ZeroPhone/ZeroPhone-PCBs/README.md

# ZeroPhone-PCBs
KiCad PCB files for ZeroPhone - Delta revision

## For Gerber and schematic files, [go to the "Releases" tab!](https://github.com/ZeroPhone/ZeroPhone-PCBs/releases/tag/delta-b)
