ZeroPhone/ZeroPhone-PCBs/art/220px-Glider.bmp

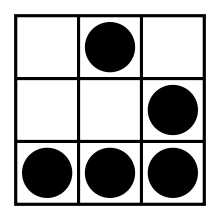
art/220px-Glider.bmp
