ZeroPhone/ZeroPhone-PCBs/bom_and_description.xls

Description | Board reference | Name, type | QTY | Price/QTY1 (per pcs) | Price/QTY1000 (per pcs) | Supplier | Notes | $/pcs when making 1000 phones | $/phone when making 1000 phones
 |  |  |  |  |  |  | QTY1 prices taken from local sellers (Riga, Latvia)/eBay
 |  |  |  |  |  |  | GBP to USD: | $1.2460
Transistors (keypad backlight&vibromotor control) | Front: Q1,Q2 | BC847B, SOT-23 | 2 | £0.07 | £0.04170 | Farnell |  | $0.0520 | 0.10
Bypass capacitors | Front: C1,C4,C5,C6,C7,C8,C13,C14,C25; Back: C5,C6,C7,C8,C13,C14,C25,C15 | 100nF, 0805 | 17 | £0.05 | £0.00440 | Farnell |  | $0.0055 | 0.09
ATMega crystal capacitors (for HC49) | Front: C2,C3 | 18pF, 0805 | 2 | £0.05 | £0.00320 | Farnell |  | $0.0040 | 0.01
Vibromotor back-EMF protection diode | Front: D1 | 1N4148, SMD (MiniMELF) | 1 | £0.10 | £0.01000 | Farnell |  | $0.0125 | 0.01
ATMega328P, in TQFP | Front: IC1 | ATMEGA328P-AU | 1 | £2 | £1.62000 | Farnell | Should be programmed with Arduino bootloader over SPI first | $2.0185 | 2.02
Resistors | Front: R3,R4,R11,R12,R13; Back: R1,R2,R3,R10,R8,R9,R11 | 10K, 0805 | 12 | £0.05 | £0.00090 | Farnell | Assuming 5000pcs/reel | $0.0011 | 0.01
Resistors (for SDIO connection) | Front: R5,R6,R7,R8,R9,R10 | 47R, 0805 | 6 | £0.05 | £0.00180 | Farnell | 6000 but typical reel is 5000, so have to buy 2 reels | $0.0022 | 0.01
Audio filtering capacitors | Front: C9,C10 | 10uF, 0805 | 2 | £0.05 | £0.02200 | Farnell |  | $0.0274 | 0.05
Audio filtering capacitors | Front: C11,C12 | 33nF, 0603 | 2 | £0.05 | £0.00700 | Farnell | price is 0.0034 but min qty is 4000 | $0.0087 | 0.02
Audio jack | Front: JACK1 | FC68125 | 1 | £0.79 | £0.51000 | Farnell | Same connector that Raspberry Pi B+/A+/2/3 use | $0.6355 | 0.64
Resistor (PWM voltage divider, audio) | Front: R1,R2 | 150R, 0603 | 2 | £0.05 | £0.00015 | Farnell |  | $0.0002 | 0.0003738
Resistor (PWM voltage divider, audio) | Front: R14,R15 | 270R, 0603 | 2 | £0.05 | £0.00015 | Farnell |  | $0.0002 | 0.0003738
ATMega crystal | Front: X1 | 16MHz, HC49 or CSTCE | 1 | £0.5 | £0.13100 | Farnell |  | $0.1632 | 0.16
Audio filtering capacitors | Front: C16,C17,C18,C19,C20,C21; Back: C22,C23,C24 | 33pF, 0603 | 9 | £0.05 | £0.01200 | Farnell | 6000 but typical reel is 5000, so have to buy 2 reels | $0.0150 | 0.13
Audio filtering capacitors | Front: C22,C23,C24; Back: C20,C21,C16,C17,C18,C19 | 10pF, 0603 | 9 | £0.05 | £0.00800 | Farnell | price/pcs is 0.006, need 3000, buying a reel of 5000 | $0.0100 | 0.09
3.3V line bypass capacitor, VBAT line bypass capacitor (for modem) | Front: C15, Back: C4 | 10uF, Tantalum, Case-B | 2 | £0.30 | £0.06000 | Farnell |  | $0.0748 | 0.15
Vibromotor current limiting resistor | Front: R16 | 1R, 0805 | 1 | £0.05 | £0.00500 | Farnell | price is 0.001 but min reel is 5000 | $0.0062 | 0.01
USB female socket | Back: P4 | USB_A | 1 | £0.5 | £0.20000 | Farnell |  | $0.2492 | 0.25
I2C GPIO expander to add GPIOs to the Pi | Back: U3 | MCP23017-E/SO | 1 | £1 | £0.73000 | Farnell |  | $0.9096 | 0.91
Battery connector | Back: P8 | SMD JST connector | 1 | £0.5 | £0.24000 | Farnell |  | $0.2990 | 0.30
RGB LED resistors | Back: R5,R6,R7 | 1K, 0805 | 3 | £0.05 | £0.00120 | Farnell | Real price is 0.0008/pcs, recalculated for 5000 reel | $0.0015 | 0.0044856
P-FETs to switch power lines | Back: Q1,Q4 | IRLML6401, SOT-23 | 2 | £0.3 | £0.07000 | Farnell |  | $0.0872 | 0.17
Schottky diode for power path switching while battery is charging | Back: D1 | SS14, any case | 1 | £0.3 | £0.16100 | Farnell |  | $0.2006 | 0.20
RTC IC | Back: U5 | DS1307, DS1337 or MCP7940N | 1 | £2 | £0.87000 | Farnell |  | $1.0840 | 1.08
RTC crystal | Back: Y1 | 32.768Hz crystal | 1 | £0.5 | £0.25000 | Farnell |  | $0.3115 | 0.31
Notification/flashlight diode | Back: D3 | RGB 5050 LED (either common-anode or common-cathode) | 1 | £1 | £0.76000 | Farnell |  | $0.9470 | 0.95
4-pin switches on the front of keypad board | Keypad: DOWN1,LEFT1,N#1,N*1,N0,N1,N2,N3,N4,N5,N6,N7,N8,N9,OK1,RIGHT1,UP1 | SKQG-like switch, preferably with elongated cap (4x4x3mm) | 17 | 0.06$ | 0.02$ | Aliexpress | keyword: "smd switch 4x4x3", Panasonic name is SKQG, but it has higher buttons | $0.02 | 0.34
2-pin switches on the front of keypad board | Keypad: C1,C2,C3,C4,C5,C6,GREEN1,RED1 | ? | 8 | 0.03$ | ? |  | couldn't yet find the name of the switch, but it's very popular and easy to source, as well as cheap (3.5x6mm) |  | 0
4-pin switches on the back of keypad board | Keypad: OPTION1,PHOTO1,PHOTO2,VOL_DOWN1,VOL_UP1 | SW_SPST_EVQP7C | 5 | 0.12$ | £0.36 | Farnell | EVQP7C switches | $0.4523 | 2.26149
ESP8266 module (for WiFi over SDIO) | Front: U2 | ESP-12E / ESP-12F | 1 | 2$ | ? | eBay |  |  | 0
OLED display | None | 1.3" SPI monochrome OLED (SH1106 controller) | 1 | 6$ | 3-4$ | eBay |  |  | 0
Speaker | None | Unknown (I'm still searching for good ones) | 1 | ? | ? |  |  |  | 0
Microphone | None | Unknown (I'm still searching for good ones) | 1 | ? | ? |  |  |  | 0
40x1 2.54 male header | None | Regular 0.1in header | 1 | £0.10 | ? |  |  |  | 0
20x2 2.54 male header | None | Regular 0.1in header | 1 | £0.10 | ? |  |  |  | 0
Front PCB | None | 4x10cm PCB, 2 layers | 1 | 1.25$ | ? | DirtyPCBs | Panelised with the keypad board (total price divided by count of boards you receive) |  | 0
Keypad PCB | None | 4x6cm PCB, 2 layers | 1 | 1.25$ | ? | DirtyPCBs | Panelised with the front board (total price divided by count of boards you receive) |  | 0
Back PCB | None | 4x10cm PCB, 2 layers | 1 | 2.5$ | ? | DirtyPCBs | (total price divided by count of boards you receive) |  | 0
Raspberry Pi Zero | None |  | 1 | 5$ | ? | Pimoroni | Shipping not included |  | 0
GSM modem | Back: U2 | SIM800L breakout | 1 | 5$ | ? | eBay |  |  | 0
Li-Ion charger board footprint | Back: U4 | TP4056 breakout with protection | 1 | 1$ | ? | eBay |  |  | 0
DC-DC breakout footprint | Back: U6 | G2116-based Chinese DC-DC | 1 | 1$ | ? | eBay |  |  | 0
 |  |  |  |  |  |  |  |  | 10.30
