ZeroPhone/ZeroPhone-PCBs/keypad_pcb/keypad_pcb.csv

Id | Designator | Package | Quantity | Designation | Supplier and ref
1 | DOWN1,LEFT1,N#1,N*1,N0,N1,N2,N3,N4,N5,N6,N7,N8,N9,OK1,RIGHT1,UP1 | SW_SPST_SKQG | 17 | AB2_SWITCH_MOMENTARY
2 |  | keypad_overlay | 1 | KEYPAD_OVERLAY
3 | C1,C2,C3,C4,C5,C6,GREEN1,RED1 | SW_SPST_EVQPE1 | 8 | AB2_SWITCH_MOMENTARY
4 | OPTION1,PHOTO1,PHOTO2,VOL_DOWN1,VOL_UP1 | SW_SPST_EVQP7C | 5 | AB2_SWITCH_MOMENTARY
