ZeroPhone/ZeroPhone-PCBs/TODO.md

#PCB TODO

* Change via drill/annular ring size near pads to make rework less problematic ( #5 )
* UART buffer addition ( #6 )
* Comparators for voltage level measurement (DC-DC overcurrent, incapable charger, main battery shutdown) ( #7 )
* Replace RGB LED by WS2812 ( #8 )
* Add diodes on keypad board ( #9 )
* Switch on USB power - power USB from charger 5V input when on charger ( #10 )
* Add more clarifications to the board schematics
* Add silkscreen + marks for polarized capacitors ( #11 )

Cat picture to make it less boring
