ZeroPhone/ZeroPhone-PCBs/(threads)

Thread 3 (2017-03-01):

EOMA specifications

dumblob, 2017-03-01:
I came across the FAQ on https://hackaday.io/project/19035-zerophone-a-raspberry-pi-smartphone/log/51834-explaining-choices-behind-the-project and wanted to mention, that there is a huge, more than 6 years running effort to:

1. Create EOMA open-source specifications of **interfaces** for HW (not the HW itself), which build upon open-source and libre concepts, eco-consciousness, sustainability over many years, and affordability.
1. Run a world-wide certification authority certifying compliance of devices with EOMA specifications.
1. Boost spreading of EOMA specifications by manufacturing some HW made according to these interfaces specifications (see e.g. https://www.crowdsupply.com/eoma68/micro-desktop ).

For more information visit http://elinux.org/Embedded_Open_Modular_Architecture and http://rhombus-tech.net/ (it's messy, but it's getting better; so far use Ctrl+F on http://rhombus-tech.net/sitemap/ ). Except for desktop PC, notebook and tablet, there is also a [phone](http://rhombus-tech.net/community_ideas/hybrid_phone/ ). These links account for about 40% of information. The whole rest is scattered in the [mailing list archives]http://lists.phcomp.co.uk/mailman/listinfo/arm-netbook ).

Some type of cooperation for the future ZeroPhone2 might be advantageous.

CRImier, 2017-03-04:
Hi! I've been following EOMA project (also, the EOMA68 implementation on CrowdSupply in particular) for some time. I like this concept, hope to get a EOMA68 laptop eventually and I'm considering this standard as one of those I could potentially use. ZeroPhone 2 isn't coming this year, but I'm already collecting information, so thank you for this =)

dumblob, 2017-03-04:
Wow, great news! I'm looking forward to cooperation and hope to hear from you sometimes at the EOMA mailing list.

(feel free to close this issue once there are more issues and things would get messy in the tracker; I'm leaving it open for other people to get a glimpse about a possible future)

CRImier, 2017-03-04:
I hope I'll join and participate in EOMA mailing list, eventually =) EOMA initiative is something that really needs to be worked on, and I'd be more than happy to be a part of it.

Hopefully,  people will continue throwing ideas and links at me - Google doesn't always help =D

Thread 10 (2017-05-14):

Powering the host USB port from charger voltage while ZeroPhone is charging

CRImier, 2017-05-14:
The USB step-up board is one of the only things that's powered from the battery even when the phone is charging (other things are GSM modem, IR expansion header, RGB LED and the MCP23017 expander). The problem is that, when there's a charger plugged in the USB port, IMO it makes sense to feed the charger input directly into the USB port. It could be done in different ways - a SPDT switch, a FET switch or something else. Waiting for comments and pull requests =)

davedarko, 2018-02-16:
You could use a power muxer like the TPS2113A on the 5V line. Whenever it's charging, the 5V would come from the same source the charger get's. If there are no 5V the chip would grab the power from the booster. So while charging there wouldn't be much current drawn. But the chip is a bit pricey. Tricky situation as it seems you use 5V, 3V3 and 4V2 simultaneously from different sources.

CRImier, 2018-02-17:
There are all kinds of integrated components to do this kind of thing - however, I need to make sure that everything in the BOM is easy to source and solder. Thus, some specialised ICs aren't really suitable, and I build stuff from what I have in the BOM + things that are easy to source on places like eBay. Today, I added a 74HC125 and a LM339, for example - these are all popular parts, they're easy to get from local sellers, Digikey and eBay shops alike =) I do have a P-FET in the BOM (IRLML6401), as well as BC847's, SS14, 10K resistors and 100nF caps.

CRImier, 2018-02-17:
Also, 3V3 and 4V2 don't even come into play in this situation - or am I missing something?

davedarko, 2018-02-18:
There's a polulu module with that chip, but that doesn't get cheaper :( I don't think I fully understood the problem then. And it's late again. But I think power muxing can help you out. Or take a look at the diode solution that some adafruit boards feature. What about a mosfet, that turns itselve on? I think I saw something like that as a simple protection circuit.

CRImier, 2018-04-25:
So, what I added: when the 5V step-up DC-DC is off, there's a circuit (2 FETs back-to-back) that connects the charger input and the 5V output. As soon as the DC-DC is turned on, the charger input and the 5V output are no longer connected. This way, when the charger is connected, the USB port can be powered by the charger - you just need to make sure the DC-DC is turned off. As a side effect, this also allows charging the ZeroPhone using a USB male-to-male cable (which will likely be necessary for OTG anyway).

Closed 2018-04-25.

Thread 11 (2017-05-14):

Adding silkscreen markings for onboard polarized capacitors

CRImier, 2017-05-14:
Currently, there's no clear designation of + orientation of the polarized capacitors on the boards. KiCad does have an asymmetric silkscreen, but it's confusing unless you explicitly look on where's the ground and where's the power connection. Waiting for pull requests =)

CRImier, 2018-02-16:
Done, should be on the Delta revision boards.

Closed 2018-02-16.

Thread 12 (2017-05-14):

Lack of 3D models for many components

CRImier, 2017-05-14:
KiCad provides board 3D view/export functionality, which would be very useful for creating ZeroPhone cases. However, for many components used by ZeroPhone there just aren't suitable 3D models. What's necessary is to find/develop simple to-scale 3D models for these components and link them to the PCB so that they appear in the 3D viewer, and can then be exported by the KiCad VRML export option for case building.

CRImier, 2017-05-14:
Addition - it's very important that 3D model source files are present, due to the fact that KiCad will be moving away from VRML in the future.

CRImier, 2017-05-17:
Components that are the most necessary for case creation:

Front board:
* Audio jack: JACK1 [(part number is FC68125)](https://crimier.wordpress.com/2017/05/16/raspberry-pi-audio-jack-part-number/)
* Microphone: W3 (currently has a terminal block 3D model, which is kinda unacceptable =) Can basically be a cylinder, [dimensions can be taken from this page](http://item.taobao.com/item.htm?id=17943296350))
* OLED screen: P2/P7 (any of those)
* ESP-12: U2 (can be taken [from this repository](https://github.com/jdunmire/kicad-ESP8266), license seems GPLv3-compatible)

Back board:
* Expansion headers: P1, P2, P3, P7 (2.54 THT angled headers)
* RGB LED: D3 (5050 case)
* SIM800 modem breakout: U2 (purely for the SIM card slot)
* TP4056 breakout: U4 (Chinese breakout board)
* 5V boost DC-DC breakout: U6 (Chinese breakout board)

Keypad board:

* 4-pin switches: UP1, DOWN1, LEFT1, RIGHT1, OK1 (SKQG switches, though with a higher pin part)
* 2-pin switches: N0-N9, N*1, N#1, C1-C6, GREEN1, RED1 (very popular and can be sold under many different codes, [photo here](http://hz00.i.aliimg.com/img/pb/795/696/038/1038696795_015.jpg))
* 4-pin/2-pin side switches: VOL_UP1, VOL_DOWN1, OPTION1, PHOTO1, PHOTO2 (EVQP7C switches )

dwaq, 2017-05-17:
In regards to ESP-12, are you using the 22 pin version or the 20 pin version? The 20 pin version uses pins 2-21.

CRImier, 2017-05-17:
@dwaq AFAIK the 3D model doesn't use the pins for model alignment on the board, instead, it uses the grid reference point, so there should be no problems =)

If the schematic didn't make it clear (I'll re-check), I'm actually using the 22-pin model of ESP-12, but some pins are removed from the ESP-12 footprint, since they're not used anyway and there's more space for routing traces and antenna keepout polygon. If the 3D model has pins that just won't be on the pads, I imagine it's not going to be an issue - this is what it looks like in reality, on a real ZeroPhone =)

CRImier, 2017-05-18:
Found the SKQG button 3D rendering [here](https://grabcad.com/library/momentary-pushbutton-5-2mm-surface-mount-smd-1)

dwaq, 2017-05-18:
I'm working on the Microphone: W3 now. What are the dimensions? I don't see details on that page and can't tell if 6mm and 5mm is height and radius or what. I can't even make sense out of it while looking at the footprint on the PCB.

PS, you can use the task list markdown for the models remaining and add a check when they're done instead of crossing out. But that's personal preference I guess.

CRImier, 2017-05-18:
Found the 2-pin switch 3D model [here](http://smisioto.no-ip.org/elettronica/kicad/kicad-en.htm)
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
2-pin SMD button on the left to the SKQG button

CRImier, 2017-05-18:
Task list - done, thank you for suggestion!

dwaq, 2017-05-18:
As for the OLED display, I found [Monochrome 1.3" 128x64 OLED graphic display on Adafruit](https://www.adafruit.com/product/938) which appears to be compatible with your design, but not the exact model that you're using. It provides dimensions but not a 3D model so I'd have to design it. Should I use these dimensions or can you find the dimensions of the display you're using? For case design, I assume screen dimensions are going to be very important, so this model needs to be correct.

CRImier, 2017-05-18:
@dwaq - you're right about screen dimensions being very important. I can't measure my screen right now, and can't check if the dimensions are right, either, but I'll measure the screens I'm using and post the dimensions today or tomorrow.

CRImier, 2017-05-18:
@dwaq Just measured the microphone, it's 5mm in width and 6mm in height.

dwaq, 2017-05-18:
I tried modeling those dimensions today and it didn't look right. Can you provide a photo of the part soldered to the board so I can see how it's supposed to look? Thanks.

CRImier, 2017-05-18:
@dwaq Here it is:
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

CRImier, 2017-05-19:
Pushed new changes - changed the crystal footprint to a reasonable one and removed pin headers that aren't actually soldered on.

dwaq, 2017-05-19:
Here's a capture of the microphone modeled at 5mm width, 6mm height. As you can see, it doesn't fill out the terminal block silkscreen like the component in your photo does. It also barely covers the holes.
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
I'll make a pull request regardless and you can either let me know what to change, or modify it yourself.

CRImier, 2017-05-19:
Hi! It should be OK, mostly it's the center position and height of microphone that matters . I'll check its height once I'll think of a way to do that. As for the possible modifications - it would be good to have a thin black layer on the top, just like it is with microphones I'm using - but nothing more, you could just paint the top black.

CRImier, 2017-05-20:
@dwaq - sorry for the screen dimension delay. Screen dimensions added in #24 (so that this issue isn't picture-heavy).

CRImier, 2017-05-20:
Added #25 for TP4056 charger breakout board

CRImier, 2017-05-20:
Fixed pin headers on back board, chaned pushed to repo

dwaq, 2017-05-24:
For RGB LED: D3 (5050 package), are [these dimensions correct for the part you're using?](https://www.adafruit.com/product/619) Especially the location of the polarity mark? I found a few 3D models of 5050 LEDs but they don't match these dimensions. If I have to model it myself, it's just going to be a cube -- I can't make it as detailed as the 3D models out there.

CRImier, 2017-05-24:
@dwaq Yes, that's the correct type. As for the dimensions - could this just be a scaling issue?

dwaq, 2017-05-24:
[This one has the wrong dimensions (CREE must do it differently)](https://grabcad.com/library/5050-plcc6-led-1)
[This one has the polarity mark on the wrong location](https://grabcad.com/library/led-smd-5050-1)
[I found this one and converted the file format and it appears ok, but I need to get permission from him to use it](https://grabcad.com/library/ws2812b-rgb-led-adafruit-neopixel-1)

CRImier, 2017-05-24:
The first one: yeah, if it could be scaled, it would be very cool.
The third one is OK too - it's a 4-pin one (instead of 6 pins), but it's not too much of a problem since this model is meant to be a guide for where to make a cutout/light path in the case, not to be 100% pin-perfect.

dwaq, 2017-05-26:
All that's left is the modules.. These are too complicated to create using my current design flow. I don't know the "correct" way to make these. Create them in KiCad and export the 3D model? Create them from the ground up in some 3D cad system? If you know of a tutorial on how this is typically done, I might be able to try it. Otherwise, I'm going to leave these items for someone else to tackle.

CRImier, 2017-05-28:
You know, making the parts as KiCad PCBs and them exporting them does make a lot of sense, I could easily do that. For example, the current GSM module is basically a PCB with a GSM module, SIM slot and pin headers. I could easily model that, and then it could be exported to VRML and imported to another board. It's still going to need some simpler blocks, like the SIM holder, the GSM modem itself (basically a flat square block) and an inductor - would you be interested in drawing those from dimensions? That'd finish the 3D modelling stage, so we could start designing cases =)

CRImier, 2017-05-28:
Also, @dwaq - could you find a good 3D model of a Pi Zero? I think that's more or less the only external part we need to put it all together.

dwaq, 2017-05-30:
As far as the module comment.. Yeah, I think I can help make some components. It might be nice to make them in a separate repo so that others can more easily find them and use them and we can just import the product of that work into this model.

CRImier, 2017-06-09:
https://github.com/ZeroPhone/BreakoutPCBMockups - done =)

Thread 5 (2017-05-14):

Changing via drill/annular ring size near pads to make rework less problematic

CRImier, 2017-05-14:
A friendly PCB designer made a comment from his experience - according to him, when there are components that are likely to be reworked, it makes sense to use larger vias and annular rings, so that, in case a PCB pad sticks off from PCB while reworking it, it would have a smaller chance of breaking off (to be fair, my memory fails me now). Rework on ZeroPhone boards would be necessary, for example, when trying out different displays, especially using the lower header (the one that has SMD pads for pinout selections).
Looking forward towards comments on whether it makes sense, as well as pull requests =)

Thread 6 (2017-05-14):

UART buffer addition

CRImier, 2017-05-14:
Currently, the Pi Zero UART (3.3V) is routed straight to the GSM UART (2.8V). The SIM800 datasheet advises against this, but fixing it would require quite some additional parts, such as a buffer of some kind, a voltage reference for 2.8V (since it's not exposed on the breakout). One more thing is that the same UART is, most likely, going to be used for the debug console - because there is just one UART, and debug console is a vital feature when doing low-level stuff and generally just debugging the reasons why system does not boot. So, theoretically, same buffer could be used for disconnecting the UART from the GSM modem - provided there's a free GPIO that could toggle the buffer, making sure that Linux boot data is not sent to the modem until the buffer is sent, and the boot console doesn't confuse the modem by printing lots of characters that may or may not contain something interpretable as AT commands. Ideally, the buffer could also be controlled by a small slide switch - so that you can signal the system not to turn the UART debug console off.

A suitable (easy to source, soldering-iron-solderable and cheap) buffer IC needs to be chosen, then added into the circuit, possibly using one of the GPIOs that are still free on the MCP23017.

CRImier, 2017-06-04:
Update - yes, the modem receives Linux boot data and this is a problem. I'll most likely work around this in software, keeping modem in RESET state (using RESET GPIO on MCP23017) until the GSM software starts.

CRImier, 2018-02-16:
Done, should be on the Delta revision boards. Both RXD and TXD of the modem are now controlled by the buffer.

Closed 2018-02-16.

Thread 7 (2017-05-14):

Adding comparators+reference for undervoltage detection

CRImier, 2017-05-14:
There are several undesirable hardware situations that need to be detected, that can't yet be detected by ZeroPhone. For example, the charging circuit can pull up to 1.5A from the charger. If the charger is not capable of providing that current, it will, possibly, drop the voltage and start overheating. It could also possibly mess with the LiIon charging board - while the chip used claims to work down to 4.0V (which in itself is weird, like, can you even charge a battery from this?), there's no guarantee the overloaded charger won't do some weird things. There are no free ADCs that could be used for determining whether the voltage is out of the bounds (there's one free ADC, but it's reserved for user applications), so technically a comparator could be used, using some free GPIOs on the MCP23017.

The 5V DC-DC chip used on the Chinese step-up breakout, while probably has some overload protection, has no way of notifying the user about output overload, while it could be very helpful while working with some USB devices. Again, a comparator could solve this.

The battery is connected to the ATMega ADC and, with firmware allowing that, could be read by the Pi Zero through ADC. However, there's no hardware shutdown when the battery is lower than 3.0V - there's a protection circuit that shuts off at 2.5V, but I personally would like the cutoff voltage to be at least 3.0V. There's already a FET that cuts off VBAT in the current version of boards (Gamma), but it's only controlled from MCP23017, which, again, is controlled by software.

Also, some of the charger circuits are prone to going into some kind of thermal runaway when overheated (static discharge might play a role, too - at least I have no other explanation yet). They don't have to be put on the charger for this to happen - and if it happens, it's a bad thing, at best, the battery will discharge quickly. It's definitely a fault of the charger boards, but we still need to be able to detect it.

A solution I imagine would be using a quad comparator out of the popular ones, and having some kind of reference for it (that'd also be sourceable, solderable and cheap, just like the comparator has to be).

- [x] Charger input undervoltage monitoring
- [x] 5V output undervoltage monitoring
- [ ] Battery charger circuit temperature detection - for a software warning
- [ ] Battery charger circuit temperature detection - with a hardware cutoff of some sorts (higher temperature than the software warning temperature)

CRImier, 2018-02-16:
Added a LM339 that monitors charger input and 5V output undervoltage (to be checked by @jaromir-sukuba ). Will also add a thermistor (or some other temperature sensor) to monitor battery charger board temperature.

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

CRImier, 2018-02-22:
Checked, looks OK. Now onto adding a thermistor.

CRImier, 2018-04-26:
Added the thermistor circuitry - I don't yet know the resistor values, these will likely need to be figured out experimentally. The layout is much more cramped now - hope it all works in the end. I didn't have any place to implement a hardware cutoff (for when the temperature is just too high), unfortunately, so will likely need to do that later. Now that I think of it, this all could really benefit from being driven by some kind of a microcontroller.

Closed 2018-04-26.

Thread 8 (2017-05-14):

Swapping RGB LED for LED with digital controller

CRImier, 2017-05-14:
Currently, the RGB LED on the board is controlled by the MCP23017 GPIO expander. The expander doesn't support any kind of PWM, so right now it's only possible to show 7 colors on the LED.

Questions:
Are more than 7 colors really necessary?
What kind of LED could be used in place of a plain RGB LED?
What kind of peripheral could be used to drive that LED?

CRImier, 2017-08-13:
UPD: it seems that APA102 LED minimum communication speed will likely be compatible with the only method of digital LED driving that's currently accessible - GPIOs through userspace through I2C expander. So, I'll order some of those LEDs and do some research.

CRImier, 2018-04-07:
It also seems like APA102 LEDs are 5V-only, which is bad - we only have VBAT and 3.3V in the PCB area where the RGB LED is located - doesn't look like we can somehow pull 5V there (and it doesn't make sense, either). Will see if I find some other option.

Thread 9 (2017-05-14):

Diodes on keypad board

CRImier, 2017-05-14:
Currently, neither firmware nor hardware of the ZeroPhone keypad allow detecting more than one key at once. While the firmware is easier to adjust, the problem with hardware is that it doesn't have the diodes, which, AFAIK, are necessary for multiple simultaneous keypress detection. 1N4148 diode in MiniMELF is already used on the front board, so that component could be used here, too (possibly, in a smaller package).

Thread 15 (2017-05-17):

back_prototype.sch old schematic component libraries

dwaq, 2017-05-17:
When I try to open [back_prototype.sch](https://github.com/ZeroPhone/ZeroPhone-PCBs/blob/master/back_pcb/back_prototype.sch), I see this helper menu. I'm not sure which part is correct, so it's probably best if you correct this issue.

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

CRImier, 2017-05-17:
Hi! I updated my KiCad to 4.0.6, and then pressed OK, and it seems to have saved the symbols instead of replacing them. Same was when I opened the front board. You can just press OK on these windows, and the issue will be solved on the next board file update, whoever of us does it first =)

CRImier, 2017-05-19:
Changes committed and pushed to the repo, thank you!

Closed 2017-05-19.

Thread 24 (2017-05-20):

3D model of display

CRImier, 2017-05-20:
As I'm going to throw in quite some photos, I'm adding a new issue for the display so that everybody who opens #12 doesn't have to load all of them.

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
Total screen width
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
Total screen height
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
Margin from PCB top to panel top
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
Margin from PCB bottom to panel bottom
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
Panel height
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
Panel width
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
Panel bottom non-active area height

CRImier, 2017-05-20:
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

CRImier, 2017-05-24:
Closed by #26 .

Closed 2017-05-24.

Thread 25 (2017-05-20):

3D model of TP4056 charger breakout

CRImier, 2017-05-20:
As I'm going to throw in quite some photos, I'm adding a new issue for the TP4056 board so that everybody who opens #12 doesn't have to load all the photos.

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
Board width
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
Board length - with MicroUSB port sticking out
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
Board length - without MicroUSB
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
Width of USB connector - without metal flaps
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
Width of MicroUSB connector - with metal flaps
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
Height of MicroUSB connector - with metal flap
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
Height of MicroUSB connector - without metal flaps
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
Depth of MicroUSB connector
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
Distance from breakout top to back PCB top - **3mm**

PCB thickness - **1mm**

CRImier, 2017-05-24:
It would also be very helpful to actually see the 8-pin IC on the breakout on the board - so that the copper can be exposed in the right place on the board, as well as to be able to position the board correctly. The IC is in SOIC-8 package and its model can be found in KiCad 3D model collection (for example, the same model is used for RTC IC on the bottom of the back board).

CRImier, 2017-06-09:
[Board modelling work started here](https://github.com/ZeroPhone/BreakoutPCBMockups/tree/master/tp4056_breakout)

Thread 27 (2017-05-24):

3D model of 5V DC-DC charger breakout board

CRImier, 2017-05-24:
As I'm going to throw in quite some photos, I'm adding a new issue for the DC-DC board so that everybody who opens #12 doesn't have to load all the photos.

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
DC-DC PCB width
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
DC-DC PCB length

The inductor on the DC-DC has to be modelled, since it's a big part that interferes with other components. It would also be very helpful to actually see the 8-pin IC on the breakout - in case it could interfere with anything else, this is pretty much the second largest component.The IC is in SOIC-8 package and its model can be found in KiCad 3D model collection (for example, the same model is used for RTC IC on the bottom of the back board).
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
Height of the inductor from board surface to inductor top - 2.1mm
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
Inductor is a square, 6.5x6.5mm
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
Distance from board edge to inductor. In another dimension, the inductor is pretty much centered on the board, I think it's safe to assume it is.

CRImier, 2017-06-09:
[Board modelling work started here](https://github.com/ZeroPhone/BreakoutPCBMockups/tree/master/dcdc_breakout)

Thread 28 (2017-05-24):

3D model of side button -

CRImier, 2017-05-24:
[A datasheet can be found here](https://industrial.panasonic.com/cdbs/www-data/pdf/ATK0000/ATK0000CE20.pdf), but I can't really find which button it applies to, and maybe that's not necessary. Basically, a block(base) (with somewhat flexible dimensions) plus block(button pin).

Pin dimensions:
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
Pin height
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
Pin width
Pin sticks out of the board outline by 0.4mm.

CRImier, 2017-05-25:
Closed by #29

Closed 2017-05-25.

Thread 33 (2017-05-25):

JST connector for battery: P8 on back board

dwaq, 2017-05-25:
Making a new issue outside of #12 because this might get photo heavy again

I found [this 3D model](https://grabcad.com/library/2-pin-jst-connector-right-angle-1) and I was attempting to add it to the board but it doesn't seem to match with the footprint.

I have it aligned in the X (x is up/down, y is left/right in this photo) direction, but need details on the Y direction. First off, does this appear to be the correct size? It's smaller than the outline in the X direction. In the Y direction, where should it align to? The edge of the PCB? If so, what set of holes do the pins fit? The ones nearest the PCB edge or the ones that are set further away? Some photos of the actual board might help me.
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

CRImier, 2017-05-25:
Photos: will do. Actually, it's my fault - I haven't really thought about through-hole connectors, mostly because I didn't have any at the time I ws drawing this connectir footprint. This kind of connector you have the 3D model for is smaller in X because it is smaller IRL - it's a different kind of connector, however, it's actually more popular and I should make it fully compatible.

I think you can just shift it inside the board for now, align with those holes that are deeper inside the board - the battery connector placement is awkward for now, shifting it in the board would make the connector stick out less. Also, if I won't be able to source SMD connectors like the one I'm using, next week when I'll be actually finishing assembly of ZeroPhone boards that arrived today, I'll certainly have to source some through-hole ones (like those that the model you have is for) and use them instead - and that'll be the way I'll use them.

Will send photos later today, now have to get to my workshop =)

CRImier, 2017-05-25:
Made the photos;

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
This is how the SMD connector looks right now. It's awkward because the plug with wires sticks out more now and is therefore more at risk of breaking, and I'll consider moving this connector further into the board - but not now.

I got one of the THT connectors, soldered them to the boards I have and this is how it looks:
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

IMO it's more reasonable, and given that I can't seem to actually source those SMD connectors here now, it seems like what I'll go with.

dwaq, 2017-05-25:
Straight down from the top - looks like it's close to the same size as yours:
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
Now here you can tell it's off a little because it's overlapping the red pads (where I circled) and yours aren't.
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
On the back you can see that the pins are a little too big for the hole.
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

This could possibly be a scaling issue, but I can't think of a way to know if it's scaled correctly or not. I scaled this model the same as all the others I've created. Should I move forward with adding this part as-is?

CRImier, 2017-05-25:
I believe the scaling doesn't matter as much here (especially as the possible error is so small), the main thing is being able to position an opening for the connector, so we can leave scaling as it is now =)

Closed 2017-05-25.

Thread 38 (2017-06-04):

The DC-DC controlling FET is put backwards - needs to be flipped

CRImier, 2017-06-04:
The problem is that it the body diode conducts even when the DC-DC is supposed to be off (and I only understood it now). I've soldered the FET upside down for the current batch of 20 ZeroPhones, but it needs to be changed in the next version.

CRImier, 2018-02-16:
Done, should be on the Delta revision boards.

Closed 2018-02-16.

Thread 39 (2017-06-04):

Back board - the ATMega header is hard to solder because of expansion headers

CRImier, 2017-06-04:
The back board has a 6-pin 2.54 header that's connected to the 6-pin ATMega programming/expansion header of the front board, and it's suggested to put a female socket on the back - so that the front board has a male header, which is easier to use for ATMega reprogramming However, currently the header holes are shifted in an awkward way, and the 6-pin header on the back board physically interferes with the 13-pin expansion header on the back board. My current solution is to file away the 6-pin female header with a file, but it's easier to just shift the 6-pin header to a lower position, which has to be done in the next version (breaking front-back board compatibility).

CRImier, 2018-02-16:
Done, should be on the Delta revision boards.

Closed 2018-02-16.

Thread 40 (2017-06-04):

Return the normal charging board placement

CRImier, 2017-06-04:
In Gamma version, I did a last-minute change to accomodate the new LiIon charging boards I got. That meant shifting the TP4056 breakout pinout out of the board outline, because the MicroUSB header was placed further than necessary. However, now it seems to me that sticking to more popular TP4056 breakouts (the ones that were used previously) would be a much better solution (not to mention that currently the breakouts used stick out of the board outlibe in a bad way, that'd interfere with case design.)

Alternatively, flipping the board could be considered - presumably, the heatsinking capability given by the soldermask opening on the board would be lost, but it could be not that big of an issue.

CRImier, 2018-02-16:
Done, should be on the Delta revision boards.

Closed 2018-02-16.

Thread 42 (2017-06-05):

Possible audio problems and improvements

CRImier, 2017-06-05:
1) The DC blocking capacitor footprints (right before audio output) are meant to be 0805 and 1206 compatible. However, their pads are too close, even for 0603, so spacing the pads further away, and decreasing their size to maintain their current dimensions, might be necessary.
2) The current audio circuit might benefit from a ground plane split in order to reduce interference (needs to be investigated)
3) 10pF and 33pF capacitors could be added on each channel in order to reduce the GSM frequency interference with the audio output

Thread 43 (2017-06-25):

A way to sense state of GSM hardware switch

CRImier, 2017-06-25:
As for now, the GSM hardware switch state can't be sensed from ZeroPhone. Thus, there isn't a way to distinguish between broken GSM modem (or the one whose firmware just crashed) and a GSM modem which was turned off in hardware. A GPIO from MCP23017 could be used for that, since there are still 5 left, but considering the comparator that could be added in the future revision, this needs more thought.

Thread 44 (2017-07-02):

Front board: add ATMega RESET button footprint

CRImier, 2017-07-02:
A button could be useful for front board ATMega programming, in case somebody is assembling the ZeroPhone independently and doesn't have a USB-UART adapter with RESET line accessible.

CRImier, 2018-02-16:
Done, should be on the Delta revision boards.

Closed 2018-02-16.

Thread 46 (2017-07-07):

ATMega serial header reverse polarity protection

CRImier, 2017-07-07:
Connecting a USB serial adapter in reverse polarity appears to burn the ATMega328P (confirmed with 5V Arduino Serial Light - happens almost instantaneously). For now, users that want to reprogram their ATMega328P should be very careful about attaching the adapter the right way - future board revisions might need some way to prevent the damage from happening.

CRImier, 2018-02-16:
Added 150R resistors right after the header, in series with TXD and RXD. Yet to be tested, but I assume it'll work. Should be on the Delta revision boards.

Closed 2018-02-16.

Thread 47 (2017-08-10):

On back board, ATMega header is reversed

CRImier, 2017-08-10:
GND pin is supposed to be on other side of the header - so the header needs to be rotated 180 degrees. This means that ATMega analog port is not correctly routed to the header in Gamma PCB version.

CRImier, 2018-02-16:
Done, should be on the Delta revision boards.

Closed 2018-02-16.

Thread 48 (2017-08-13):

Add a PCB identification EEPROM

CRImier, 2017-08-13:
The EEPROM could be used by zerophone_hw library and ZeroPhone UI, to identify between different versions of ZeroPhone PCBs. It's very likely to appear in the next version of PCBs, and will likely be added on I2C1 (user-accessible I2C), since I2C0 GPIOs are already taken by ESP8266 CH_PD and MCP23017 INT lines, and toggling them while OS is running could mean software breakage (mcp23x08 getting fake
interrupt signals, and esp8089 drivers suddenly losing the ESP8266 communication).

CRImier, 2018-02-16:
Done, should be on the Delta revision boards.

Closed 2018-02-16.

Thread 49 (2017-08-13):

Add UART pads near LiIon charging PCB outline

CRImier, 2017-08-13:
A mod board (replacement for LiIon PCB) can be developed, in order to have USB-UART access over the MicroUSB charging socket. For that, 1) a PCB with CP2102 and additional holes/castellations has to be developed 2) the UART traces (that go nearby) have to be brought to pads on PCB. The problem is that the debugging will be unusable when GSM modem will be active - but, considering the fact that there's already compatibility for both using UART as GSM modem comms channel and as a debug channel, this shouldn't be that big of a problem. Also, coupled with UART buffer addition (#6), a GSM modem-side override could easily be implemented, so that it'd be possible to use debugging console without modem receiving all the debugging info.

CRImier, 2017-08-31:
The corresponding board is ready, though yet to be tested: https://github.com/ZeroPhone/ZeroPhone-Mod-PCBs/tree/master/tp4056_usb_board

CRImier, 2018-02-16:
Done, should be on the Delta revision boards.

Closed 2018-02-16.

Thread 50 (2017-08-13):

Move lower display header + fix SMD pads for display

CRImier, 2017-08-13:
As of now, when jumpering SMD pads to pins of the lower display header (as it's necessary to wire the display to signal pins on ZeroPhone), some solder goes into the plated holes and makes a small solder bulge, that, due to unfortunate positioning of the header, can short out to the OLED panel FPC pins. A temporary fix with Kapton tape can be used, but undesired as a requirement. So, this needs to be fixed in some way that doesn't involve post-processing
To add to that, unused pads could be removed from the footprint, to eliminate confusion. Also, silkscreen markings could really help avoid some costly mistakes, such as supplying reverse polarity voltage to the screen, destroying it in the process - though all the silkscreen additions probably warrant their own separate issue.

CRImier, 2018-02-16:
Done, should be on the Delta revision boards.

Closed 2018-02-16.

Thread 51 (2017-08-26):

Add small 6-pin header separator PCBs into main repo

CRImier, 2017-08-26:
There will be 2 6-pin headers linking the back and front boards (right now, one of them is 4-pin but it'll be changed). When Pi Zero is soldered on the back board, however, there's a 1.6mm offset, which needs to be compensated for by a spacer, and a piece of 1.6mm PCB seems to be the most suitable material. In addition to that, the PCB might also work as a holder for the GSM antenna wire (so that it doesn't obstruct the miniHDMI connector).

CRImier, 2018-02-16:
Done, should be on the Delta revision boards.

Closed 2018-02-16.

Thread 52 (2017-08-26):

Needed silkscreen markings on PCBs

CRImier, 2017-08-26:
Front board:
- [x] Display SMD jumper pad connector pinout (#50)
- [x] Microphone polarity markings
- [x] SMD jumper pad configuration for the Heltek.cn display (likely to be the one used in production&kit versions) (#50)
- [x] Polarized capacitor polarity markings (given that most caps are tantalums, show a rectangle with a line corresponding to the line on capacitors, not just + sign) (#11)
- [x] ATMega programming header pinout (+warning about inserting the other way) (#46)
- [x] UART, VSYS and 4-pin keypad header pin names
- [x] Names for jumpers that can be cut/shorted (audio mod board overrides, ATMega GPIO mapping to 6-pin header, IR_RX/IR_TX)
- [x] R and C markings for 10K and 100nF, more detailed markings for elements with different values (put disambiguation somewhere)
- [x] For GSM filtering capacitor groups, add either "10pF" or "33pF" markings, depending on which are supposed to go where
- [x] More clear Pin 1 marking for ATMega

Back board:
- [x] Directions on soldering order: charging board first, then GSM modem, then 5V DC-DC, then USB port, then the USB testpoint wires and then the Pi Zero
- [x] Polarized capacitor polarity markings
- [x] Names for jumpers that can be cut/shorted (IR_RX/IR_TX, GSM power)
- [x] "Pull apart here" markings to see how to pull front board and back board apart
- [x] Expansion header pinout (possibly, better accomplished by stickers, for most headers)
- [x] "Hold to power" marking for FET override button
- [x] R and C markings for 10K and 100nF, more detailed markings for elements with different values
- [x] For GSM filtering capacitor groups, add either "10pF" or "33pF" markings, depending on which are supposed to go where
- [x] More clear Pin 1 marking for MCP23017

Keypad board:
- [x] Keypad row and column pin markings (for easier debugging)
- [x] Tips on soldering the keys

18650 holder board:
- [x] Version information
- [x] Battery polarity
- [x] First use instructions
- [x] 18650 battery handling warnings

CRImier, 2018-02-16:
Done, should be on the Delta revision boards.

Closed 2018-02-16.

Thread 54 (2018-01-12):

pdf version for schematics

JDat, 2018-01-12:
add (automatically?) pdf version of schematics to repository.

CRImier, 2018-01-12:
Keeping schematic and gerber files in the repository is kind of painful - you need to keep them up-to-date each time you change something, so you need to regenerate them and upload them along your changes - and it quickly makes your repository huge. So, then the repository history becomes bloated and it's hard to download it (since gerbers/images are binary files and git can't work with them as easily as with text files).

Furthermore, only the release schematics/gerbers are actually useful to most of people, since PCBs are only ordered from release versions - the in-repo files are typically work-in-progress, and their schematics aren't even useful for hardware/software developers. So, go to the ["Releases"](https://github.com/ZeroPhone/ZeroPhone-PCBs/releases) tab, grab the .zip of the latest release and you should be good to go - it contains both gerbers and the schematics!

Thread 55 (2018-02-16):

Add SIM card insertion guideline to back board bottom silkscreen

CRImier, 2018-02-16:
If there's no good place for it, a sticker could also be used.

CRImier, 2018-04-03:
As SIM slot positioning with 2G and 3G modems will be different, I decided to go with a sticker.

Closed 2018-04-03.

Thread 57 (2018-02-17):

Changing through-hole pads to oval ones

CRImier, 2018-02-17:
In order to make ZeroPhone more reworkable, we need to make sure that pads stay on the board. @dwaq advice is:

```
In regards to the pad delamination, oval pads are typically stronger because there's more surface area, yet you can retain the spacing between the pins.
```

So, some of the through-hole pads should be made oval. I think it makes sense to do it for
- [x] GSM modem
- [x] front-to-keypad board connections
- [x] JST connector
- [x] USB port
- [x] Microphone

Possible but problematic places:
- [x] 40-pin Pi Zero headers (there are traces between them)

Places where holes can't/shouldn't be
- Both 6-pin headers - there are traces going near them
- Display header (8-pin and 7-pin holes are too close)
- Audio jack footprint (the routing around it is cramped)
- Expansion headers - not meant to be reworked (little use in reworking them), and not enough place

dwaq, 2018-02-19:
I'll start work on this over at https://github.com/dwaq/ZeroPhone-PCBs/tree/oval-pads

CRImier, 2018-02-19:
Great, thank you! I just had to stop working on it, as I'm working on my side job. If you need any advice, materials (like photos) or something else, please let me know.

dwaq, 2018-02-19:
I made PR #58 which makes oval pads on the 5x parts you mentioned "makes sense". The pads are changed and the new footprints are imported into the boards (front and back pcbs were modified). Because the pads are different sizes now, they interact with the VCC and GND pours and those will need to be modified - I did not do this. The traces to these may not need to be modified, but they should be checked.

As a general rule I made the pads 1.33x as big on one side as the other (this is what KiCad uses on the default library's oval pads). It's fairly simple to modify the footprints in a text editor if you think a different size would be better.

The microphone was a stock terminal block, so I made a new part from that and modified it to have oval pads.

dwaq, 2018-02-19:
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

As for the RPi header, you can make offset oval pads as seen in this screenshot. You can make it so they only point to the outside and you can still run a signal between the rows. There's some parts that will need to be moved if the footprint is modified in this way, so I did not attempt it. Another option is to only increase the size of the pads that have room to do so. At least the design would be improved by as many pads as you can modify.

CRImier, 2018-02-19:
Thank you! Could you also adjust the keypad board? (as it has the front-to-keypad connections footprint in it, too)

dwaq, 2018-02-19:
Oh ok, I didn't think of that. Will do

dwaq, 2018-02-19:
The keypad PCB now has the new footprint. I also had to regenerate and import the netlist to fix some DRC errors.  I think it was out of date.
The netlist in the `gitignore` so this board doesn't have one in the repo.
The front PCB has a netlist in the repo but I think it's also out of date because the PCB has DRC errors.  It's outside the scope of this issue but I wanted to alert you of it.

CRImier, 2018-02-19:
Thank you! I'll have to make sure I check all boards for DRC stuff, then - I have a habit of doing this, but now it seems I've missed the keypad board.

CRImier, 2018-02-22:
Checked it from my side, adjusted where necessary. @dwaq thank you for the help!

Thoughts:
- Audio header could indeed use oval holes, just in case (I never ever had to rework one, but I imagine it could become necessary in some case)
- Display header will definitely need oval holes (it's given me a lot of grief with the Gamma batch), however, care should be taken to preserve 7-pin display compatibility
- I'm not sure Pi Zero header could use oval holes - will need to think about it. I had some breakage while reworking a Pi Zero, but it's a tricky process by itself and people won't use it often.

dwaq, 2018-02-22:
If this issue is still open in a week, I can work on those 2 headers. Won't have time until then.

dwaq, 2018-03-13:
This is still on my radar, just got busy and haven't been able to work on it yet. I'll comment when I get a chance to start on it, but feel free to take it on yourself if you need it done before I get to it.

CRImier, 2018-03-16:
No problems, did it now =) Changed front board headers to use 1.524x1.9 oval pads - the rework there shouldn't be too hard anyway. Changed back board headers to 1.524x2 - I will see if rework is better, maybe I will need to increase the pins further.

CRImier, 2018-03-16:
Will try to improve the display headers now - other than that, this is completed! Thank you, @dwaq , for your help on this =)

Closed 2018-03-16.

Thread 59 (2018-02-19):

Move the RGB LED up, to where it works better as a flashlight

CRImier, 2018-02-19:
The RGB LED, as placed on Gamma boards, needs some kind of light guide to be more useful as a flashlight, since it's covered by the 18650 holder. My proposition is: move it higher on the board and cut a corner off the 18650 board, so that it shines through (currently, the 18650 board has a cutout for the light guide, but the corner is intact).

Problems:

- Some kind of light guide would still be useful - as, by default, the LED is quite diffused
- We need to move a 100nF capacitor, which is there both for the top expansion port and for the LED.

CRImier, 2018-02-19:
Hmm, we can put that capacitor on the top of the back board - the top expansion socket isn't exactly in the corner, there's some room left.

CRImier, 2018-02-22:
Moved the capacitor to the top, then shifted the RGB LED up a little - now need to see if that's enough

CRImier, 2018-03-12:
Moved the capacitor even further up, after thinking more about it - now it should be easy to make it shine through! The last thing left is modifying the 18650 board accordingly.

CRImier, 2018-04-03:
Done.

Closed 2018-04-03.

Thread 60 (2018-08-09):

TPA2005 amplifier needs a ground pad on the footprint

CRImier, 2018-08-09:
Currently (Delta), the TPA2005 footprint center pad is not exposed. We need to add it, for better soldering possibilities, as well as in case the amplifier ends up heating up too much during, say, a loudspeaker cal

CRImier, 2018-08-09:
For now, done with a mask opening.

Thread 61 (2018-08-09):

Silkscreen missing ESP-12 footprint pins

CRImier, 2018-08-09:
During assembly, a project's contributor was confused by missing ESP12 pins. Adding silkscreen ellipses where two deleted pins are would help eliminate this problem. Not sure KiCad supports it, though - worst case, I'll add two filled rectangles.

CRImier, 2018-08-09:
Done!

Closed 2018-08-09.

Thread 62 (2018-08-09):

Move battery connector down ~1-2mm; SMD connector further into the board

CRImier, 2018-08-09:
Currently (Delta), a through-hole battery connector is interfering with the SIM5300EA breakout - by a really small margin, but it's going to be a bigger problem for the SMD connector. It only needs to be moved ~1-2mm down, so that it doesn't interfere with Pi Zero instead. Additionally, the SMD connector needs to be moved a little bit further into the board - to make sure the connector plug's body doesn't stick out of the ZP outline.

Thread 63 (2018-08-09):

MCP_INT is push-pull on boot - expected open-drain, needs a PNP transistor in series

CRImier, 2018-08-09:
MCP23017, unexpectedly, has the INT pins in the push-pull mode on boot (at least it's still active low). This interferes with HAT EEPROM detection by Pi Zero, since it expects the GPIO0 to not be driven and instead pulled up to VCC. So, we need to add this solution between MCP23017 and Pi Zero/EEPROM:

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
[Draft1.asc.txt](https://github.com/ZeroPhone/ZeroPhone-PCBs/files/2272456/Draft1.asc.txt)

This also means we need to add a jellybean PNP transistor to the BOM. This is a suitable solution by now, but I'll look into whether we have a way around it.

CRImier, 2018-08-09:
Done!

CRImier, 2021-11-13:
This can - and ought've been - done with a diode. Next version should use a diode instead.

Thread 64 (2018-08-09):

Switchover transistor and DCDC_EN FET can't coexist - need to add Schottky diode

CRImier, 2018-08-09:
The switchover circuit on Delta boards doesn't work as expected - the DCDC_EN is supposed to both control the FET that's switching the 5V DC-DC on and off, as well as the transistor that's enabling the switchover circuit. However, in practice, the transistor pulls DCDC_EN down when it's not yet configured as input - from the moment the phone (and MCP23017) is powered, till the moment the 5V DC-DC is first enabled/disabled (at that moment, the software sets the DCDC_EN GPIO as output).  We could workaround that in software, but it's a hack. Instead, I came up with the following solution:

- The transistor (that enables the switchover) is controlled from the charger input (through a 10K resistor) instead of DCDC_EN
- A signal Schottky diode is added, pulling the transistor's base down whenever the DCDC_EN is low (and, consecutively, DCDC is enabled)

This enables the switchover when the charger is connected, but disables the switchover whenever DCDC is enabled.

The problem is - we need to add another BOM entry, as well as source another component. Therefore, if any other ideas are proposed, I'll be happy to hear them.

CRImier, 2018-08-09:
For now, the Schottky solution is implemented.

CRImier, 2019-01-15:
Works!

Closed 2019-01-15.

Thread 65 (2018-08-09):

BC847 pinout in charger-USB switchover circuit has wrong footprint

CRImier, 2018-08-09:

CRImier, 2018-08-09:
Done!

Closed 2018-08-09.

Thread 66 (2018-08-09):

TL431 current limiting resistor needs 0805 (handsoldering) footprint

CRImier, 2018-08-09:
This is desirable in case a custom resistor is needed and can't be reasily sourced.

CRImier, 2018-08-09:
Done!

Closed 2018-08-09.

Thread 67 (2018-08-09):

Both tantalum capacitors on back board have wrong description - 100nF=>100uF

CRImier, 2018-08-09:

CRImier, 2018-08-09:
Done!

Closed 2018-08-09.

Thread 68 (2018-08-09):

Back board: R23 and Q1 interfere with certain charger boards

CRImier, 2018-08-09:
Certain charger&protection boards have "flaps" on the OUT side, because of a different panelization process (that some manufacturers use). We need to make sure those flaps don't interfere with aforementioned components - currently, those flaps would need to be cut away with tin snips.

CRImier, 2018-08-09:
Done!

Closed 2018-08-09.

Thread 69 (2018-08-09):

RGB LED doesn't have polarity markings

CRImier, 2018-08-09:
Even though there are different 5050 LEDs with different polarities/pinouts, we need to mark the polarity for the LED version that we're suggesting (as well as add polarity disclaimer to the sourcing guidelines).

CRImier, 2018-08-09:
Done!

Closed 2018-08-09.

Thread 70 (2018-08-11):

Comparator reference and inputs out of common mode range

CRImier, 2018-08-11:
LM339 has common mode range of 0V - Vcc-2V, which, for us, translates into 0V-1.3V. On Delta boards, everything is set up so that reference voltage is 2.5V (straight from TL431) and undervoltage triggers are around the same level, which is a mistake I let through because I didn't know about the fact there's a common mode range requirement. Suggested fix:

1) Divide the TL431 voltage by 2 using a 10K-10K resistor divider
2) Change the undervoltage resistor dividers in a way that divides the 4.6V trigger point into the TL431 voltage (approx. 1.25V)
3) Adjust the thermocouple resistors accordingly (thermistor wasn't yet tested).

CRImier, 2018-08-11:
Sorta implemented on Delta-B boards - TL431 voltage is divided, but resistor values haven't yet been changed in the schematic/BOM.

CRImier, 2019-01-13:
I think we can remove the comparator - it's finicky and not that useful.

Closed 2019-01-13.

Thread 72 (2018-09-22):

Conversion to KiCAD5

eeyrjmr, 2018-09-22:
Present project appears to be using KiCAD4 library structure. KiCAD5 changed this. Automatic migration not complete.

Request roadmap for toolchain upgrade

CRImier, 2018-10-04:
Likely when I'll finish my current ZeroPhone mod PCBs that I'm designing - after next week, then I will need to look into making cases, and could switch files to KiCad5 while we're at it.

eeyrjmr, 2019-01-16:
That is odd.. KiCAD presents a library mapping dialog

> This schematic currently uses the project symbol library list look up method for loading library symbols. KiCad will attempt to map the existing symbols to use the new symbol library table. Remapping will change some project files and schematics may not be compatible with older versions of KiCad. All files that are changed will be backed up to the “remap_backup” folder in the project folder should you need to revert any changes. If you choose to skip this step, you will be responsible for manually remapping the symbols.

and equally when git status is executed:

git status
On branch master
Your branch is up to date with 'origin/master'.

Changes not staged for commit:
  (use "git add <file>..." to update what will be committed)
  (use "git checkout -- <file>..." to discard changes in working directory)

	modified:   front_pcb/front_prototype-cache.lib
	modified:   front_pcb/front_prototype-rescue.lib
	modified:   front_pcb/front_prototype.pro
	modified:   front_pcb/front_prototype.sch

CRImier, 2019-01-16:
Ah, I see, I misunderstood what you meant. Yeah, I had these changes too, will check the extent and whether I made the conversion fully, then push into a branch - or maybe even into master (with a disclaimer that files are no longer backwards compatible with 4 - that's true, right?)

eeyrjmr, 2019-01-26:
yup that is true.
To be fair when I raised the bug it wasn't just project conversion, there were alot of parts missing (from the schematic and 3D symbols for the view).

when you responded I did a fresh pull and equally was on KiCAD-5.0.1  and the main issues were resolved (probably gentoo ebuild and library layout...) but the project conversion is still valid

CRImier, 2019-05-13:
Pushed the KiCad5-updated schematic files - I didn't push the PCB files yet, I need to bring my 3D model work results into an upload-able state.

Closed 2023-01-09.

Thread 75 (2019-01-13):

Need to remove the comparator

CRImier, 2019-01-13:
It's finicky, hard to implement (need to add weird resistors to the BOM), hard to adjust (because of thermistor variations), and overall is not that useful compared to the benefits (4 free GPIOs, free board space, can attach Velcro again) that its removal brings.

Thread 76 (2019-01-13):

Need to debug the ID EEPROM in-system flashing

CRImier, 2019-01-13:
It's come to my attention that the ID EEPROM flashing still might be broken - now, because of the ESP CH_EN pin connected in parallel with SDA, seems like it might have a capacitor on it and it results in the EEPROM not being detected.

Thread 78 (2019-01-13):

Research adding a thermistor pin

CRImier, 2019-01-13:
Pouch cells could really use thermistor support - TP4056 supports a 10K thermistor, however, it's typically not broken out. In addition to that, most batteries do not have a thermistor - do we need to add one? We could add one to the 18650 holder.

Thread 79 (2019-01-16):

Back board: add + and - on the top silkscreen near the I2C header

CRImier, 2019-01-16:
When inserting I2C addons, you need to check polarity before insertion - this is a good habit. In order to do that, you need to flip the phone. However, it'd help if there were + and - markings on the back board instead, on the top - they should be visible from the gap between the Pi Zero and the back PCB.

Thread 80 (2019-01-19):

Keypad row/column markings wrong on the front board?

CRImier, 2019-01-19:
A user that did self assembly reported that, during their investigation, they've noticed the c1-c6 and r1-r5 markings on the front board (denoting keypad rows and columns) seem flipped. Need to investigate further and check if it's really so.

Thread 81 (2019-01-27):

Need to move resistors/capacitors from under the audio mod socket so that it's SMD-mountable

CRImier, 2019-01-27:
At the moment, it's hard to mod the ZeroPhone with the audio buffer mod board - you need to add some pin headers and solder them in a peculiar way. It'd be easier if one could just solder the filter board flush to the front board. In order to do that, we need to move the SMD resistors and capacitors out of the mod board's outline so that it's actually possible to accomplish. We'll also need to change the mod board itself, but that's an issue for another repo =)

Thread 83 (2019-02-21):

Consider switching the ZP display to CS1 of SPI

CRImier, 2019-02-21:
It's come to my attention that there's plenty of software hard-coded to use CS0 by default. For example, that's how the default device tree overlays behave in Raspbian - many of those are hard-coded to use SPI0 CS0. While it's certainly possible to send pull requests and all that, I'd rather make the software a little bit more user-friendly. This will result in loss of backwards compatibility, no doubt - however, I'm sure we can work around that somehow, i.e. using the ID EEPROM.

Thread 84 (2019-02-28):

Add 6-pin header type markings to PCBs

CRImier, 2019-02-28:
On back PCB, there's a male 6p header on top (with a spacer between the header plastic and the PCB) and female 6p header on the bottom. On front PCB, there's a female header on top and male header on the bottom (with a spacer between the header plastic and the PCB). We need to make sure this isn't confused during assembly, so we need to add "male" and "female" markings on the PCB. Also, we might want to a reminder about spacers that have to go between headers and PCBs.

Thread 85 (2019-03-10):

Reverse polarity protection for the battery

CRImier, 2019-03-10:
It's come to my attention that reverse polarity protection is needed for the ZeroPhone battery. I've plugged batteries in reverse a couple of times myself, with varying levels of damage, and esp. with Gamma revision there's a lot of reports about people plugging the battery incorrectly (since the cheap plastic holders actually have wrong polarity marked when compared to the 18650 PCB). I've researched this in the past, and here's a circuit that I've found, that's replicated perfectly with no additional BOM items:

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

[Blog post about it ](http://blog.deconinck.info/post/2017/12/22/18650-Battery-charger-reverse-polarity-protection) here ([archive link](http://archive.is/kiQVW)), with some explanation and useful discussion.

Thread 86 (2019-03-10):

Reverse polarity protection for 5V input?

CRImier, 2019-03-10:
I personally haven't had any accidents so far, but it makes sense that, at some point, a user might miswire the 5V input (CHG) and reverse the wires. We have two points of entry for 5V input (used for 1) LiIon charging 2) powering the system while 5V is connected ), these ports are 1. MicroUSB port on the TP4056 board (not controlled by us 2. CHG pin on the bottom side header.

What could we do?

1. Add a P-FET protecting the 5V line as it comes from the pad of the TP4056 board. Unfortunately, it doesn't protect the TP4056 chip on the TP4056 board itself, since there's a direct connection between TP4056 and the MicroUSB port, and we don't control that connection.
2. Add a P-FET on the bottom header, so that 1) the USB switchover circuit is also protected 2) -5V (miswired) from the header won't get to the TP4056 board
3. Add a SS14 diode (reverse biased) in parallel with the 5V input as it comes from the TP4056 board, i.e. on the other side of the TP4056 board (once the comparator resistors are gone). This won't help prevent problems if the diode burns out, but it will short the charger, hopefully put it into short-circuit mode and prevent damage.
  a. Is it possible we could also add a red reverse-biased LED+resistor, to notify the user about the miswiring?

Thread 87 (2019-04-02):

Add battery polarity markings near the battery connector

CRImier, 2019-04-02:
If you're using external batteries, it's possible to mix up the battery polarity and buy a battery with the wrong polarity connector, and then plug that battery in, destroying the phone. So, we need to have some kind of polarity markings on the PCB - on top silkscreen layer, where the battery is plugged in.

Thread 88 (2019-04-02):

Add I2C testpoints / QWIIC connector on back board

CRImier, 2019-04-02:
Right side of the phone (in the space between back board, front board and 40-pin connectors, where the "Pry apart here" markings are) seems to be a good spot where one could add some I2C sensors, i.e. an accelerometer/gyro, or a contactless temperature sensor. However, we should make this easier - to be exact, we need to add VCC (3.3V), GND, SDA and SCL testpoints there, in a spot where the user can solder to them with a soldering iron. We can even add a QWIIC connector there!

Thread 89 (2019-04-02):

Add alignment lines for the 2x20 female header on the front board

CRImier, 2019-04-02:
During soldering of the 40-pin header, it needs to be parallel to the board outlines:

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

In order to help with that, some straight lines might help align the header better. Even though silkscreen thickness varies from fab to fab (and with cheaper fabs, from board to board), it still might be a worthwhile thing to do. Maybe wavy lines could help if the line is made thicker by the fab?

Thread 90 (2019-04-11):

Replace 10K power source switchover P-FET pulldown with 1K8

CRImier, 2019-04-11:
Currently, unless there's a large and low-ESR capacitor in parallel with VSYS, a ZeroPhone might reboot when you unplug the charger. However, swapping the P-FET pulldown resistor from 10K to 1.8K fixes this problem, making the FET open quicker.

Thread 91 (2019-04-25):

Add "top"/"bottom" layer markings to the boards

CRImier, 2019-04-25:
For writing more clear assembly instructions, we need to refer to different sides of the PCBs. In KiCad, there's "top" and "bottom" layers, and we could use these as directions - but when you hold the PCBs in your hands, it's not clear which is which. So, we could add some more markings to the silkscreen.

Thread 92 (2019-04-25):

Add "+, 1" and "-, 2" markings to DC-DC (for soldering)

CRImier, 2019-04-25:
During assembly, it's easier if the user first solders the input pin of the DC-DC to the back board (as it needs less heat to solder and therefore will be easier to re-align). So, we can add "+, 1" and "-, 2" markings on the silkscreen to signal the pin order (and, possibly, also somewhat help people that might use a custom DC-DC instead of the recommented one)

Thread 93 (2019-05-13):

Back/front board speaker polarity mismatch

CRImier, 2019-05-13:
A contributor has reported that, when comparing the schematics, it seems that SPK-/SPK+ on back board are connected to SPK+/SPK- on the front board respectively (through the 6-pin header). This needs to be fixed.

Thread 95 (2021-11-13):

USB-C charging boards - need to add back PCB cutouts/drill markings?

CRImier, 2021-11-13:
USB-C charging boards should be a good upgrade. However, the usual Type-C sockets have shell THT pins going through the board, with a thin enough charger board, the shell pins will prevent the board from being flush. This asks for either mid-mount Type-C sockets (can still interfere mechanically + less space for charger components) or for some kind of cutouts to be added to the back board. Possible alternative - adding silkscreen polygons for spots which the user can drill out for a generic Type-C TP4056 board to be mountable flush.

Thread 96 (2021-11-13):

GPIO mapping could use reconsideration

CRImier, 2021-11-13:
There's not a lot of GPIOs that the Pi Zero has exposed (even less when using an ESP8266 for WiFi). However, the I2C header currently has one of the GPIOs shared with the IR header, and that's kinda cringe. In addition to that, a Type-C mod board will take one GPIO away from the I2C pin header with its INT, and I'd expect a Type-C port to be a relatively popular mod.

Thread 97 (2021-11-13):

Adding testpoints for amplifier soldering check

CRImier, 2021-11-13:
The TPA2005 speaker amplifier is currently the lowest-pitch component on the ZP PCBs, with 0.5mm pitch. Someone attaching it with a soldering iron will need a good way to check its soldering quality, adding testpoints for every pin on the front would help detect shorts between pins or bad solder joints. In addition to that, if testpoints are well-placed enough, patch boards could be made for even easier soldering.

Thread 98 (2021-11-13):

Adding FPC footprint on both front and keypad boards for keypad connections

CRImier, 2021-11-13:
It's clear to me, by now, that pin headers connecting the keypad and the front boards fail a tad too often. As a backup way of connecting the boards, two 0.8mm FPC sockets could be used, with the pin headers then not being required for connectivity and, possibly, even replaceable by some kind of shims/stubs. This would also make keypad replacements much easier.

Thread 99 (2021-11-26):

The DCDC FET could use a soft-start capacitor and a testpoint on the back

CRImier, 2021-11-26:
Switching the DC-DC on while on battery power sometimes draws too much current and resets the ZP. A soft-start capacitor would solve that, and it'd be cool to also have a testpoint for the DCDC signal on the back so that the DC-DC signal can be overridden or probed.
