ZeroPhone/ZeroPhone-PCBs/(commit log)

2017-01-17 Alpha revision uploaded - opening on other PC not yet tested
    [back_prototype-B.Cu.gbl, back_prototype-B.Mask.gbs, back_prototype-B.SilkS.gbo, back_prototype-Edge.Cuts.gko, back_prototype-F.Cu.gtl, back_prototype-F.Mask.gts, back_prototype-F.SilkS.gto, back_prototype.drl]
2017-01-21 Next revision - untested
    This revision incorporates many fixes and fixes compared to the alpha
    (all the traces were erased and drawn again, because some components had
    to be added and some had to be removed). However, this isn't a release -
    I haven't ordered these boards yet, I'm now asking people to take a look
    at them to minimize the possibility of having wrong boards made. these
    will be ordered after the Chinese holidays.
    The schematic is now slightly easier to understand, only three
    connections are unrouted (and only one actually won't be connected, I'll
    look into it but it's fixable by a solder jumper/0R resistor).
    [front_prototype.kicad_pcb, front_prototype.sch, ltc2990_sensor.kicad_pcb, ltc2990_sensor.sch]
2017-01-22 Intermediate state - the schematic and PCB are out of sync and there's a list of fixes to be made!
    * crystal - shorten ground return path
    * motor - resistor in series to avoid problems if motor short-circuits
    * ground fill between mosi and clk?
    * reposition ATMega reset pullup to non-clean 3.3V supply
    * smaller gap between mic lines
    * add a tantalum capacitor footprint near ESP
    * add the rest of perimeter GND vias
    * Change via drill/annular ring size to make rework more robust
    * Add a cap close to vibromotor circuit
    * Vibromotor PWM control wire interrupting ground plane - move a little
    to one or another side
    [front_prototype.kicad_pcb, front_prototype.sch]
2017-01-23 rerouted tracks
    clearance changed to 0,16mm, track rearranged to gain some groundplane
    [front_prototype.kicad_pcb]
2017-01-23 minor tweaks
    D1 corrected polarity, added RF supression caps
    [front_prototype.kicad_pcb, front_prototype.sch]
2017-01-23 final first rev
    C1 is against GND now, minor tweaks
    [front_prototype.kicad_pcb, front_prototype.sch]
2017-01-23 Finishing touches
    Added the tantalum capacitor
    Added a capacitor next to vibromotor
    Added all perimeter GND vias
    Shortened crystal ground return path
    Added a resistor in series with motor
    [front_prototype.kicad_pcb, front_prototype.sch]
2017-01-23 Forgot some vias, adding
    [front_prototype.kicad_pcb]
2017-01-23 Gerbers generated
    Can be viewed on
    https://gerber-viewer.easyeda.com/showcase/#!id=32b5fe01e19811e69ed5026a86b9cae7
    [front_prototype-B.Cu.gbl, front_prototype-B.Mask.gbs, front_prototype-B.SilkS.gbo, front_prototype-F.Cu.gtl, front_prototype-F.Mask.gts, front_prototype-F.SilkS.gto, front_prototype.drl]
2017-01-25 Made gerbers suitable for OSHPark
    [front_prototype-Edge.Cuts.gm1]
2017-01-25 New keypad PCB
    [keypad_prototype-B.Cu.gbl, keypad_prototype-B.Mask.gbs, keypad_prototype-B.SilkS.gbo, keypad_prototype-Edge.Cuts.gm1, keypad_prototype-F.Cu.gtl, keypad_prototype-F.Mask.gts, keypad_prototype-F.SilkS.gto, keypad_prototype.drl]
2017-01-25 Started new back PCB
    [back_prototype-B.Cu.gbl, back_prototype-B.Mask.gbs, back_prototype-B.SilkS.gbo, back_prototype-Edge.Cuts.gko, back_prototype-F.Cu.gtl, back_prototype-F.Mask.gts, back_prototype-F.SilkS.gto, back_prototype.drl]
2017-01-26 Some more schematic work on back PCB
    [back_prototype.sch]
2017-01-26 Beautiful annotations
    So fabulous
    [back_prototype.sch, front_prototype.sch]
2017-01-31 Back board almost finished
    [back_prototype.kicad_pcb, back_prototype.sch]
2017-01-31 Back board finished - untested, not pretty
    [back_prototype-B.Cu.gbl, back_prototype-B.Mask.gbs, back_prototype-B.SilkS.gbo, back_prototype-Edge.Cuts.gm1, back_prototype-F.Cu.gtl, back_prototype-F.Mask.gts, back_prototype-F.SilkS.gto, back_prototype.drl]
2017-02-04 Started annotating components and making the BOM document
    [bom_and_description.xls, front_prototype.csv, front_prototype.sch]
2017-02-04 Some forgotten changes for previous commit
    [front_prototype.kicad_pcb]
2017-02-08 Made LTC2990 current sensor addon, untested
    [ltc2990_sensor.kicad_pcb, ltc2990_sensor.sch]
2017-02-08 OpenGL router fuckup
    [back_prototype.kicad_pcb]
2017-02-08 Added ground pads to current sensor
    [ltc2990_sensor.kicad_pcb, ltc2990_sensor.sch]
2017-02-10 Moved BOM file to the root folder
    [bom_and_description.xls]
2017-02-10 Rerouted one track that wasn't beautiful
    [keypad_prototype.kicad_pcb]
2017-02-10 Exported BOM from keypad board
    [keypad_prototype.csv]
2017-02-10 Added component values to the back PCB - for BOM
    [back_prototype.kicad_pcb, back_prototype.sch]
2017-02-10 Exported back PCB BOM
    [back_prototype.csv]
2017-02-10 BOM document almost finished
    Need to look up all prices and add some clarifications
    [bom_and_description.xls]
2017-02-14 Intermediate BOM version (Excel problems?)
    [bom_and_description.xls]
2017-02-14 BOM almost ready
    [bom_and_description.xls]
2017-02-14 Redrawn the current sensor board
    [ltc2990_sensor.kicad_pcb, ltc2990_sensor.sch]
2017-02-14 Most of BOM finished - will need to consult somebody about sourcing bigger components
    [bom_and_description.xls]
2017-02-15 Minor changes
    [bom_and_description.xls]
2017-03-05 Added audio buffer mod board - to be checked and tested!
    [zerophone_audio_buffer.kicad_pcb, zerophone_audio_buffer.sch]
2017-03-05 Small explanation in front board schematic
    [front_prototype.sch]
2017-03-06 Removed a weird trace left after a push&shove, some more changes
    [back_prototype.kicad_pcb]
2017-03-06 MCP RESET pin connected to 3V3, moved some symbols so that schematic is more clear
    [back_prototype.sch]
2017-03-06 SSD1332 breakout - no board yet
    [ssd1332_breakout.kicad_pcb, ssd1332_breakout.sch]
2017-03-07 Started SSD1332 board
    TODO:
    * Check display header
    * Pick smaller components
    * Scan one of the OLED breakout PCBs and import outline from it
    * Check about MC34063 layout guidelines
    [ssd1332_breakout.kicad_pcb, ssd1332_breakout.sch]
2017-03-07 Fixes and features for the front board
    * Added 7-pin header
    * Added trace closing the audio buffer override jumper
    * Lowered ATMega header pin count to 6 pins, one is selectable between
    ATMEGA_RST and ATMEGA_GPIO
    * Added a capacitor in series with ATMEGA_RST pin (for easier
    programming using off-the-shelf adapters)
    * Added a LED to ATMega PB5 (Arduino Pin 13) - optional, useful mostly
    for debugging
    * Added fiducials
    * Moved traces to get a ground plane between I2C and SPI, as well as
    between SPI MOSI and SPI CLK
    * Moved GSM audio filtering capacitors near mic to other layer
    * Changed all 0603 footprints to handsoldering ones
    * Fixed audio jack silkscreen so that it's shown correctly at the b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
    [front_prototype.kicad_pcb, front_prototype.sch]
2017-03-07 More front boards features/fixes
    * Added place for audio-to-ground resistors (like on Pi 3) * Bigger
    holes in pin headers
    [front_prototype.kicad_pcb, front_prototype.sch]
2017-03-11 Corrected buffer pinout; changed power symbols
    [zerophone_audio_buffer.kicad_pcb, zerophone_audio_buffer.sch]
2017-03-13 Back board sch - pin swapping
    Pins rearranged for gamma revision
    [back_prototype.sch]
2017-03-13 Front board sch - pins swapped
    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
    [front_prototype.sch]
2017-03-13 Front board BRD - pins swapped
    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
    [front_prototype.kicad_pcb]
2017-03-13 Shifted ESP-12 further into board outline
    Was sticking out for half a millimeter in beta board
    [front_prototype.kicad_pcb]
2017-03-14 Added audio buffer gerbers
    [zerophone_audio_buffer-B.Cu.gbl, zerophone_audio_buffer-B.Mask.gbs, zerophone_audio_buffer-B.SilkS.gbo, zerophone_audio_buffer-Edge.Cuts.gm1, zerophone_audio_buffer-F.Cu.gtl, zerophone_audio_buffer-F.Mask.gts, zerophone_audio_buffer-F.SilkS.gto, zerophone_audio_buffer.drl]
2017-03-14 Saved gerber settings
    [zerophone_audio_buffer.kicad_pcb]
2017-03-14 Added .gml file to audio buffer gerbers, regenerated .zip
2017-03-14 Added PCB art module directory; added hacker glider symbol
2017-03-14 Added hacker glider symbol and version info to keypad board; regenerated gerbers
    [keypad_prototype-B.Cu.gbl, keypad_prototype-B.Mask.gbs, keypad_prototype-B.SilkS.gbo, keypad_prototype-Edge.Cuts.gm1, keypad_prototype-F.Cu.gtl, keypad_prototype-F.Mask.gts, keypad_prototype-F.SilkS.gto, keypad_prototype.drl]
2017-03-14 Added OSHW logo footprints
2017-03-14 Added OSHW logos and revision info
    [front_prototype.kicad_pcb]
2017-03-14 Moved a trace that could show from the soldermask
    [front_prototype.kicad_pcb]
2017-03-14 Regenerated front board gerbers
    [front_prototype-B.Cu.gbl, front_prototype-B.Mask.gbs, front_prototype-B.SilkS.gbo, front_prototype-Edge.Cuts.gm1, front_prototype-F.Cu.gtl, front_prototype-F.Mask.gts, front_prototype-F.SilkS.gto, front_prototype.drl]
2017-03-14 Wrong capacitor footprint for some reason; regenerated gerbers
    [front_prototype-B.Cu.gbl, front_prototype-B.Mask.gbs, front_prototype-B.SilkS.gbo, front_prototype-Edge.Cuts.gm1, front_prototype-F.Cu.gtl, front_prototype-F.Mask.gts, front_prototype-F.SilkS.gto, front_prototype.drl]
2017-03-14 Updated TODO with last front board additions
2017-03-15 Back board almost finished - lots of changes
    [back_prototype.kicad_pcb, back_prototype.sch]
2017-03-15 Updated TODO and schematic clarifications
    [back_prototype.sch]
2017-03-15 Cleaning up ground planes
    [back_prototype.kicad_pcb]
2017-03-17 Cleared up ground, removed testpoints
    Removed some ground and I2C GPIO expander testpoints
    [back_prototype.kicad_pcb, back_prototype.sch]
2017-03-18 Minor changes
    - Added MakeRiga reference
    - Added basic audio jack ESD protection
    - Modified audio jack output capacitor footprint so that 1206 would
    kinda fit
    [front_prototype.kicad_pcb, front_prototype.sch]
2017-03-18 Fixed audio jack footprint on front board
    [front_prototype.kicad_pcb]
2017-03-19 Rearranged audio connector pads on front board
    [front_prototype.kicad_pcb, front_prototype.sch]
2017-03-19 Final changes
    * Modified footprints to have bigger holes
    * Added OSHW logo, release information and references
    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
    [back_prototype.kicad_pcb, back_prototype.sch]
2017-03-19 Regenerated back board gerbers
    [back_prototype-B.Cu.gbl, back_prototype-B.Mask.gbs, back_prototype-B.SilkS.gbo, back_prototype-Edge.Cuts.gm1, back_prototype-F.Cu.gtl, back_prototype-F.Mask.gts, back_prototype-F.SilkS.gto, back_prototype.drl]
2017-03-21 Minor back PCB changes
    Moved some testpoints and a capacitor
    [back_prototype.kicad_pcb]
2017-03-21 Regenerated gerbers for back board
    [back_prototype-B.Cu.gbl, back_prototype-B.Mask.gbs, back_prototype-B.SilkS.gbo, back_prototype-Edge.Cuts.gm1, back_prototype-F.Cu.gtl, back_prototype-F.Mask.gts, back_prototype-F.SilkS.gto, back_prototype.drl]
2017-03-21 Plotted back board schematics in SVG and PNG
2017-03-21 Generated front board schematic's SVG and PNG
2017-03-23 Last minute changes in back board
    * Added a VSYS capacitor
    * Added a capacitor in parallel with the battery
    * Removed the MCP_INT testpoint and testpoints for free MCP GPIOs
    * Remove the footprint for additional protection IC
    * Stitched the board with vias
    * Moved the traces around for better grounds
    [back_prototype.kicad_pcb, back_prototype.sch]
2017-03-23 Regenerated gerbers
    [back_prototype-B.Cu.gbl, back_prototype-B.Mask.gbs, back_prototype-B.SilkS.gbo, back_prototype-Edge.Cuts.gm1, back_prototype-F.Cu.gtl, back_prototype-F.Mask.gts, back_prototype-F.SilkS.gto, back_prototype.drl]
2017-03-25 Last minute changes to front PCB
    * Added a GSM speaker cutout, moved its testpoints
    * Added a cutout where the ESP-12 antenna is
    * Adjusted ATMega's crystal's ground restrict polygon
    * Moved fiducials so as to avoid silkscreen lines on them
    * Moved ESD diode and audio-to-ground resistors to front layer
    * Decreased ground fill clearances
    [front_prototype.kicad_pcb]
2017-04-30 Fixed minor mistakes on current sensor board
    [ltc2990_sensor.kicad_pcb]
2017-04-30 Generated current sensor board gerbers
    [ltc2990_sensor-B.Cu.gbl, ltc2990_sensor-B.Mask.gbs, ltc2990_sensor-B.SilkS.gbo, ltc2990_sensor-Edge.Cuts.gm1, ltc2990_sensor-F.Cu.gtl, ltc2990_sensor-F.Mask.gts, ltc2990_sensor-F.SilkS.gto, ltc2990_sensor.drl]
2017-04-30 Updated GitHub page for gamma boards
2017-04-30 Updated README and TODO with pcb_todo.txt
    Also removed pcb_todo.txt
2017-05-03 Updated back board
    * Added a footprint for MPU9050/9150 breakouts
    * Added a FET that interrupts VBAT+ and is controlled from GPIO expander
    (with a button to reset it?)
    [back_prototype.kicad_pcb, back_prototype.sch]
2017-05-03 Started using GPIO4 for IR TX
    [back_prototype.kicad_pcb, back_prototype.sch, front_prototype.kicad_pcb, front_prototype.sch]
2017-05-03 Fixed protection footprint
    More like "fucked shit up because Chinese modules"
    [back_prototype.kicad_pcb, back_prototype.sch]
2017-05-04 Front board fixes
    Centered display headers, un-hardwired 7-pin display header, moved
    crystal keepout to make better ground for ATMega, made speaker
    attachment testpoint larger
    [front_prototype.kicad_pcb, front_prototype.sch]
2017-05-04 Added fiducials to back board (forgot them? Merge conflict?)
    [back_prototype.kicad_pcb]
2017-05-04 Adjusted fiducial coordinates to have less significant digits
    [front_prototype.kicad_pcb]
2017-05-06 18650 holder board almost ready
    [18650_pcb.kicad_pcb, 18650_pcb.sch]
2017-05-06 Almost ready; needs cutouts for breakouts and positioning of connector
    [18650_pcb.kicad_pcb, 18650_pcb.sch]
2017-05-06 Finished 18650 PCB
    * Added LED cutout
    * Added battery charge module cutout
    * Checked dimensions
    * Added DC-DC cutout
    [18650_pcb.kicad_pcb]
2017-05-06 Generated 18650 board gerbers
    [18650_pcb-B.Cu.gbl, 18650_pcb-B.Mask.gbs, 18650_pcb-B.SilkS.gbo, 18650_pcb-Edge.Cuts.gm1, 18650_pcb-F.Cu.gtl, 18650_pcb-F.Mask.gts, 18650_pcb-F.SilkS.gto, 18650_pcb.drl]
2017-05-07 Small fixes
    Enlarged GPIO expander pads (where they were made smaller before)
    Removed mask near MicroUSB connector to make it possible to solder it to
    the board (for worst case of MicroUSB connector being prone to breaking
    off)
    [back_prototype.kicad_pcb]
2017-05-07 Adjusted solder mask clearance, moved traces that weren't covered
    [back_prototype.kicad_pcb]
2017-05-07 Moved some traces and a resistor
    [back_prototype.kicad_pcb]
2017-05-07 Regenerated schematic SVGs
2017-05-07 Added schematic PDFs
2017-05-07 Added SPI flash programming mod board
    [spi_soicw8_programming.kicad_pcb, spi_soicw8_programming.sch]
2017-05-07 Generated gerbers for SPI flash programming mod board
    [spi_soicw8_programming-B.Cu.gbl, spi_soicw8_programming-B.Mask.gbs, spi_soicw8_programming-B.SilkS.gbo, spi_soicw8_programming-Edge.Cuts.gm1, spi_soicw8_programming-F.Cu.gtl, spi_soicw8_programming-F.Mask.gts, spi_soicw8_programming-F.SilkS.gto, spi_soicw8_programming.drl]
2017-05-07 Added ATMega programming mod board
    [atmega_isp_programming.kicad_pcb, atmega_isp_programming.sch]
2017-05-07 Generated gerbers for ATMega programming mod board
    [atmega_isp_programming-B.Cu.gbl, atmega_isp_programming-B.Mask.gbs, atmega_isp_programming-B.SilkS.gbo, atmega_isp_programming-Edge.Cuts.gm1, atmega_isp_programming-F.Cu.gtl, atmega_isp_programming-F.Mask.gts, atmega_isp_programming-F.SilkS.gto, atmega_isp_programming.drl]
2017-05-09 Added back and Li-Ion holder board combined gerbers
    Lots of additional stuff on the panels, so you might want to generate
    your own if you want to fill the empty space with something of yours =)
    [combined.GKO, combined.drl, combined.gbl, combined.gbo, combined.gbs, combined.gm1, combined.gtl, combined.gto]
2017-05-09 Added front and keypad board combined gerbers
    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
    [combined.GKO, combined.drl, combined.gbl, combined.gbo, combined.gbs, combined.gm1, combined.gtl, combined.gto]
2017-05-14 Was referencing Gamma boards as v1.0 in README, fixed
2017-05-17 Swapped 3D models from HandSoldering to normal
    [back_prototype.kicad_pcb, front_prototype.kicad_pcb]
2017-05-17 use KiCad's enviroment variables to refer to art directory
2017-05-17 add 3D model for ESP-12E
    [front_prototype.kicad_pcb]
2017-05-18 export FC68125 model as stl
2017-05-18 export from wings as vrml
2017-05-18 add 3D FC68125 model to layout and rotate/shift to line up
    [front_prototype.kicad_pcb]
2017-05-18 use relative path
    [front_prototype.kicad_pcb]
2017-05-18 use typical IC material color for audio jack
2017-05-18 add direction and OK button 3D models
    [keypad_prototype.kicad_pcb]
2017-05-18 add number pad buttons
    [keypad_prototype.kicad_pcb]
2017-05-18 add 2 pin switch buttons
    [keypad_prototype.kicad_pcb]
2017-05-19 Resolved the sch symbol replacement dialog
    [back_prototype.sch, front_prototype.sch]
2017-05-19 Moved/deleted/swapped pin headers
    [front_prototype.kicad_pcb]
2017-05-19 Fixed keypad board outline
    [keypad_prototype.kicad_pcb]
2017-05-19 Fixed absolute path for ESP-12 3D model
    [front_prototype.kicad_pcb]
2017-05-19 add 3D model to pcb
    [front_prototype.kicad_pcb]
2017-05-19 Place 2x20 female header on back of PCB
    These shifts assume PCB is 1.6mm (0.0629921 inches) thick, which is how
    KiCad 3D models it.
    [front_prototype.kicad_pcb]
2017-05-19 add 40 pin male header for pi to back of board
    I used the same technique as #22, so there's possibility for adjustment
    [back_prototype.kicad_pcb]
2017-05-20 Flipped the back board 40 pin header to 180 degrees
    [back_prototype.kicad_pcb]
2017-05-20 3D model fixes
    Changed pin headers to female headers
    Removed header at accelerometer spot
    Moved USB header to not interfere with RTC IC
    [back_prototype.kicad_pcb]
2017-05-22 PCB complete
2017-05-22 combine PCB and display
2017-05-22 add to PCB
    Position at X and Y are approximate.
    Z position places the display flush with the header
    Rotation required due to model and PCB differences
    [front_prototype.kicad_pcb]
2017-05-23 hard code the screen into the 3D file
    If you regenerate the file using Wings3D, you'll have to modify this part by hand to get it back
2017-05-23 color the model
    blue for pcb
    black for display screen
    silver for display edges
2017-05-23 align P2 display with P1 header
    This assumes that the P1 header is centered vertically in the 5mm gap above the display on the pisplay PCB
    This also assumes that the P2 header is centered horizontally on the PCB
    [front_prototype.kicad_pcb]
2017-05-24 generate side button
2017-05-24 add part to PCB
    [keypad_prototype.kicad_pcb]
2017-05-24 Increase height of keys to 1.1mm
    [keypad_prototype.kicad_pcb]
2017-05-24 Add colors to Display
    For future reference (RGB):
    Blue: 28 74 123 (PCB)
    Silver: 216 216 216 (Edges of display)
    Black: 0 0 0 (Active display area)
2017-05-24 color the side button
    Silver RGB: 216 216 216
2017-05-24 place the 3D model in the other 4 buttons
    [keypad_prototype.kicad_pcb]
2017-05-24 Add APA1020C LED to PCB
    [back_prototype.kicad_pcb]
2017-05-24 add attibution for using LED 3D model
2017-05-25 Added 2 pin JST connector for battery
    [back_prototype.kicad_pcb]
2017-05-30 Placed Raspberry Pi Zero on back board
    [back_prototype.kicad_pcb]
2017-05-30 Add colorized model
    [back_prototype.kicad_pcb]
2017-06-26 Fixed a duplicate line in keypad PCB
    [keypad_prototype.kicad_pcb]
2017-06-26 Regenerated keypad PCB gerbers
    [keypad_prototype-B.Cu.gbl, keypad_prototype-B.Mask.gbs, keypad_prototype-B.SilkS.gbo, keypad_prototype-Edge.Cuts.gm1, keypad_prototype-F.Cu.gtl, keypad_prototype-F.Mask.gts, keypad_prototype-F.SilkS.gto]
2017-06-26 Some files got regenerated for some reason
    [back_prototype.csv, front_prototype.csv, front_prototype.kicad_pcb]
2017-06-26 18650 gerbers regenerated for some reason
    [18650_pcb-B.Cu.gbl, 18650_pcb-B.Mask.gbs, 18650_pcb-B.SilkS.gbo, 18650_pcb-Edge.Cuts.gm1, 18650_pcb-F.Cu.gtl, 18650_pcb-F.Mask.gts, 18650_pcb-F.SilkS.gto, 18650_pcb.drl]
2017-06-26 Front PCB gerbers regenerated for some reason
    [front_prototype-B.Cu.gbl, front_prototype-B.Mask.gbs, front_prototype-B.SilkS.gbo, front_prototype-Edge.Cuts.gm1, front_prototype-F.Cu.gtl, front_prototype-F.Mask.gts, front_prototype-F.SilkS.gto]
2017-06-26 Cleared obsolete schematic renderings
2017-06-26 Re-generated front board schematic renderings
2017-07-08 Added crypto EEPROM mod board
    http://www.atmel.com/images/Atmel-8885-CryptoAuth-ATSHA204A-Datasheet.pdf
    [crypto-eeprom-B.Cu.gbl, crypto-eeprom-B.Mask.gbs, crypto-eeprom-B.SilkS.gbo, crypto-eeprom-Edge.Cuts.gm1, crypto-eeprom-F.Cu.gtl, crypto-eeprom-F.Mask.gts, crypto-eeprom-F.SilkS.gto, crypto-eeprom.drl]
2017-07-18 Moving mod boards to ZeroPhone/ZeroPhone-Mod-PCBs
    [atmega_isp_programming-B.Cu.gbl, atmega_isp_programming-B.Mask.gbs, atmega_isp_programming-B.SilkS.gbo, atmega_isp_programming-Edge.Cuts.gm1, atmega_isp_programming-F.Cu.gtl, atmega_isp_programming-F.Mask.gts, atmega_isp_programming-F.SilkS.gto, atmega_isp_programming.drl]
2017-08-18 Removed mod boards from repo
    [ltc2990_sensor-B.Cu.gbl, ltc2990_sensor-B.Mask.gbs, ltc2990_sensor-B.SilkS.gbo, ltc2990_sensor-Edge.Cuts.gm1, ltc2990_sensor-F.Cu.gtl, ltc2990_sensor-F.Mask.gts, ltc2990_sensor-F.SilkS.gto, ltc2990_sensor.drl]
2017-08-26 Silkscreen additions for keypad board
    -Notes on soldering
    -Tips for soldering
    -Pin names
    [keypad_prototype.kicad_pcb, keypad_prototype.sch]
2017-08-27 Re-thought and re-traced 13-pin header pinout
    I2S part will likely get changed later, too
    [back_prototype.kicad_pcb, back_prototype.sch]
2017-08-28 Adding aux axis
    [keypad_prototype.kicad_pcb]
2017-08-28 Moving text a little
    [keypad_prototype.kicad_pcb]
2017-08-28 Bumping the revision
    [keypad_prototype.kicad_pcb]
2017-08-28 Renaming the project files from "prototype" to "pcb"
    [keypad_pcb.csv, keypad_pcb.kicad_pcb, keypad_pcb.sch]
2017-08-28 Starting gerber file removal
    [keypad_prototype-B.Cu.gbl, keypad_prototype-B.Mask.gbs, keypad_prototype-B.SilkS.gbo, keypad_prototype-Edge.Cuts.gm1, keypad_prototype-F.Cu.gtl, keypad_prototype-F.Mask.gts, keypad_prototype-F.SilkS.gto, keypad_prototype.drl]
2017-09-01 18650 PCB modifications
    -Added version information
    -Added a fuse between two batteries
    -Added polarity silkscreen markings
    -Removed traces from bottom layer to prevent them from shorting out to
    metal on back PCB
    -Added pads for hand-soldering JST connector wires onto the board
    [18650_pcb.kicad_pcb, 18650_pcb.sch]
2017-09-01 More 18650 board modifications
    -Added helper texts
    -Moved one trace further from outline
    [18650_pcb.kicad_pcb]
2017-09-01 More helper&warning text
    -Battery connector pinout&wire color codes
    -LiIon battery warnings
    -"read this before use" clarification
    [18650_pcb.kicad_pcb]
2017-09-05 Small changes to front board
    KEYPAD_GPIO now shared with DISPLAY_RST (through a NO jumper)
    Audio buffer board is now powered by VSYS
    [front_prototype.kicad_pcb, front_prototype.sch]
2017-09-05 Side header labels renamed to I2S pin names
    [back_prototype.kicad_pcb, back_prototype.sch]
2017-09-05 Removing panel gerbers from repository
    [combined.GKO, combined.drl, combined.gbl, combined.gbo, combined.gbs, combined.gm1, combined.gtl, combined.gto]
2017-09-05 Removing gerbers from repo
    [18650_pcb-B.Cu.gbl, 18650_pcb-B.Mask.gbs, 18650_pcb-B.SilkS.gbo, 18650_pcb-Edge.Cuts.gm1, 18650_pcb-F.Cu.gtl, 18650_pcb-F.Mask.gts, 18650_pcb-F.SilkS.gto, 18650_pcb.drl]
2017-09-05 Final changes to 18650 board
    -Tweaked outline for better fit
    -Added some more text and a little art
    [18650_pcb.kicad_pcb]
2017-11-23 Flipped the GSM modem footprint
2017-11-23 Removing gerbers from repository
    [front_prototype-B.Cu.gbl, front_prototype-B.Mask.gbs, front_prototype-B.SilkS.gbo, front_prototype-Edge.Cuts.gm1, front_prototype-F.Cu.gtl, front_prototype-F.Mask.gts, front_prototype-F.SilkS.gto, front_prototype.drl]
2017-11-23 Removing old schematics from repository
    [front_prototype.csv]
2017-11-23 GSM modem and removing features
    -Flipped the GSM modem, improving the board dramatically
    -Removed MPU-9150 header
    -Removed RTC footprint
    -Removed board center-facing USB port
    -Added inductors in series with microphone (not yet added to the PCB)
    -Swapped pins of the IR header so that plugging an IR expansion board in
    reverse wouldn't kill it
    [back_prototype.kicad_pcb, back_prototype.sch]
2017-11-23 Removed gerbers&schematics from the repository
    [back_prototype.csv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]
2018-02-16 Front board changes for Delta version
    [front_prototype.kicad_pcb, front_prototype.sch]
2018-02-16 Lots of changes for the Delta revision
    [back_pcb.kicad_pcb, back_pcb.sch, back_prototype.kicad_pcb]
2018-02-16 Renaming WP (write protect) into WE (write enable)
    [back_pcb.kicad_pcb, back_pcb.sch]
2018-02-16 Added a 6-pin header separator PCB (closes #51)
    [6p_separator.kicad_pcb, 6p_separator.sch]
2018-02-16 Silkscreen additions
    [back_pcb.kicad_pcb, front_prototype.kicad_pcb]
2018-02-16 More silkscreen changes
    [back_pcb.kicad_pcb, back_pcb.sch, front_prototype.kicad_pcb, front_prototype.sch]
2018-02-16 Added a UART buffer, TX/RX testpoints, 1N4148 and other silk changes
    [back_pcb.kicad_pcb, back_pcb.sch, front_prototype.kicad_pcb]
2018-02-16 Adding 10pF and 33pF caps to modem VBAT
    [back_pcb.kicad_pcb, back_pcb.sch]
2018-02-16 Added silkscreen markings for 10pF and 33pF modem VBAT caps
    [back_pcb.kicad_pcb, back_pcb.sch]
2018-02-16 Added Zener for modem, silkscreen changes, fill adjustments
    [back_pcb.kicad_pcb, back_pcb.sch]
2018-02-16 Adding 10pF and 33pF for 3.5 jack filtering, fixed DRC
    [front_prototype.kicad_pcb, front_prototype.sch]
2018-02-16 Added LM339 - monitoring charger and 5V stepup undervoltage
    [back_pcb.kicad_pcb, back_pcb.sch]
2018-02-16 Added 150R resistors in series with UART - reverse header insertion protection attempt
    [front_prototype.kicad_pcb, front_prototype.sch]
2018-02-19 use footprint on pcb
    [back_pcb.kicad_pcb]
2018-02-19 replace keypad footprint with oval
    [front_prototype.kicad_pcb]
2018-02-19 change JST thru hole pad to oval
2018-02-19 replace JST connector with oval pad version
    [back_pcb.kicad_pcb]
2018-02-19 replace USB connector with oval pad version
    [back_pcb.kicad_pcb]
2018-02-19 create new footprint for microphone based on old terminal block
    replaced pads with offset oval pads
2018-02-19 replace microphone footprint with new oval pad version
    [front_prototype.kicad_pcb]
2018-02-19 replace keypad footprint on keypad pcb with oval pad version
    [keypad_pcb.kicad_pcb]
2018-02-19 regenerate netlist because it was out of date
    [keypad_pcb.kicad_pcb]
2018-02-22 Unfucked the SIM800 footprint and added it, shifted two holes for a ground fill, moved the top exp. header capacitor to top layer and shifted the RGB LED up
    [back_pcb.kicad_pcb]
2018-02-22 Checked oval holes, reworked some traces
    [front_prototype.kicad_pcb]
2018-02-22 Added a 10K resistor pulling up the buffer's unused gate ENs, cleaned up silkscreen
    [back_pcb.kicad_pcb, back_pcb.sch]
2018-02-22 Adjusted JST footprint, connected USB shield to ground, moved some traces and silkscreen labels
    [back_pcb.kicad_pcb, back_pcb.sch]
2018-02-24 Moved VBAT Zener&100nFcapacitor a little bit, adjusted the JST connector 3D model
    [back_pcb.kicad_pcb]
2018-02-24 Made schematic prettier, fixed the DC-DC FET
    [back_pcb.kicad_pcb, back_pcb.sch]
2018-03-12 Moved the RGB LED further up
    [back_pcb.kicad_pcb]
2018-03-12 Some more 18650 board fixups
    [18650_pcb.kicad_pcb]
2018-03-12 Back board changes
    Changing 5-pin header footprint to match the RPi 5-header group
    Moving the hardware ID EEPROM to I2C0 (ID_SD and ID_SC) pins
    Adding pullup on the other I2C pin, as it's required per Pi HAT EEPROM
    schematic
    Removed TV_OUT pin from Pi Zero footprint
    [back_pcb.kicad_pcb, back_pcb.sch]
2018-03-12 Exported the GSM modem layout footprint
2018-03-12 Adding Gerber files to .gitignore
2018-03-15 Removing keypad row/column markings from the board
    [keypad_pcb.kicad_pcb]
2018-03-30 Enabling layers - just in case
    [6p_separator.kicad_pcb]
2018-03-30 Adding speaker adapter board - needs to be printed out
    [speaker_adapter.kicad_pcb, speaker_adapter.sch]
2018-03-30 Oval pads in the Pi Zero footprint
2018-03-30 Making the C letter smaller in 100nF cap footprint
2018-03-30 Increasing prev. decreased drills in keypad overlay
2018-03-30 Staggered holes in the front board top display header
2018-03-30 Improved, separate microphone footprint
2018-03-30 Added serial number field., integrated footprint changes, redrew some traces
    [back_pcb.kicad_pcb]
2018-03-30 Integrated footprint changes, redrew some traces
    [front_prototype.kicad_pcb]
2018-04-03 Updated speaker adapter to better reflect reality
    [speaker_adapter.kicad_pcb, speaker_adapter.sch]
2018-04-03 Front board Pi Zero footprint - no Pi outline on silk anymore
2018-04-03 Adjusted 18650 board outline, routing and silk to match the back board
    [18650_pcb.kicad_pcb]
2018-04-03 Removed MCP23017 addr jumpers, added fiducials, specified EEPROM model, added power-button-sense circuit, removed battery capacitor
    [back_pcb.kicad_pcb, back_pcb.sch]
2018-04-03 Added fiducials, changed audio header to match the back board
    [front_prototype.kicad_pcb, front_prototype.sch]
2018-05-02 Added audio amp, improved crystal footprint, fixed footprint associations
    [front_prototype.kicad_pcb, front_prototype.sch]
2018-05-02 Added TP4056 temp sensing, charger-USB switchover and updated the 6-pin connector to have VBAT
    [back_pcb.kicad_pcb, back_pcb.sch]
2018-05-06 Keypad now has better mechanical strength
    [keypad_pcb.kicad_pcb]
2018-05-06 Updating front board's keypad wiring, display pin via stitching
    [front_prototype.kicad_pcb]
2018-05-06 Updated keypad PCB traces for mechanical stability
    [front_prototype.kicad_pcb]
2018-05-24 Minor rerouting
    [front_prototype.kicad_pcb]
2018-08-09 Removed the outdated schematic PDF
2018-08-09 Changes towards Delta-B #69 #68 #67 #66 #64 #65 #63
    [back_pcb.kicad_pcb, back_pcb.sch]
2018-08-09 Changes towards Delta-B #60 #61
    [front_prototype.kicad_pcb]
2018-08-11 Revision label updates, origin points
    [18650_pcb.kicad_pcb, keypad_pcb.kicad_pcb]
2018-08-11 Speaker adapter v1.1 - edge holes adjusted for 1.6mm PCBs
    [speaker_adapter.kicad_pcb]
2018-08-11 Removing schematic from repository
2018-08-11 Comparator reference now 1V2, changing text a little bit
    [back_pcb.kicad_pcb, back_pcb.sch]
2018-08-11 Updating revision label
    [front_prototype.kicad_pcb, front_prototype.sch]
2019-04-28 Started KiCad 5 migration
    Opened each schematic, "rescued" symbols, then saved the files. No .kicad_pcb file changes so far.
    [18650_pcb.sch, 6p_separator.sch, back_pcb.sch, front_prototype.sch, keypad_pcb.sch, speaker_adapter.sch]
